mekatronik-achmadi/ecu_gea_v1/interface_win32/batik.png

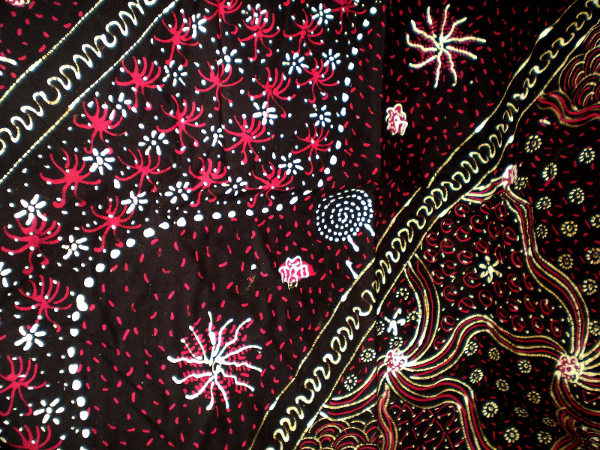
interface_win32/batik.png
