mekatronik-achmadi/ecu_gea_v1/README.md

ecu_gea_v1
==========

engine controller unit for gea engines. curently input only RPM and TPS
