mekatronik-achmadi/ecu_gea_v1/boards/PCB_Separated/platform_all1.brd

## EAGLE design boards/PCB_Separated/platform_all1.brd (2014-09-28)

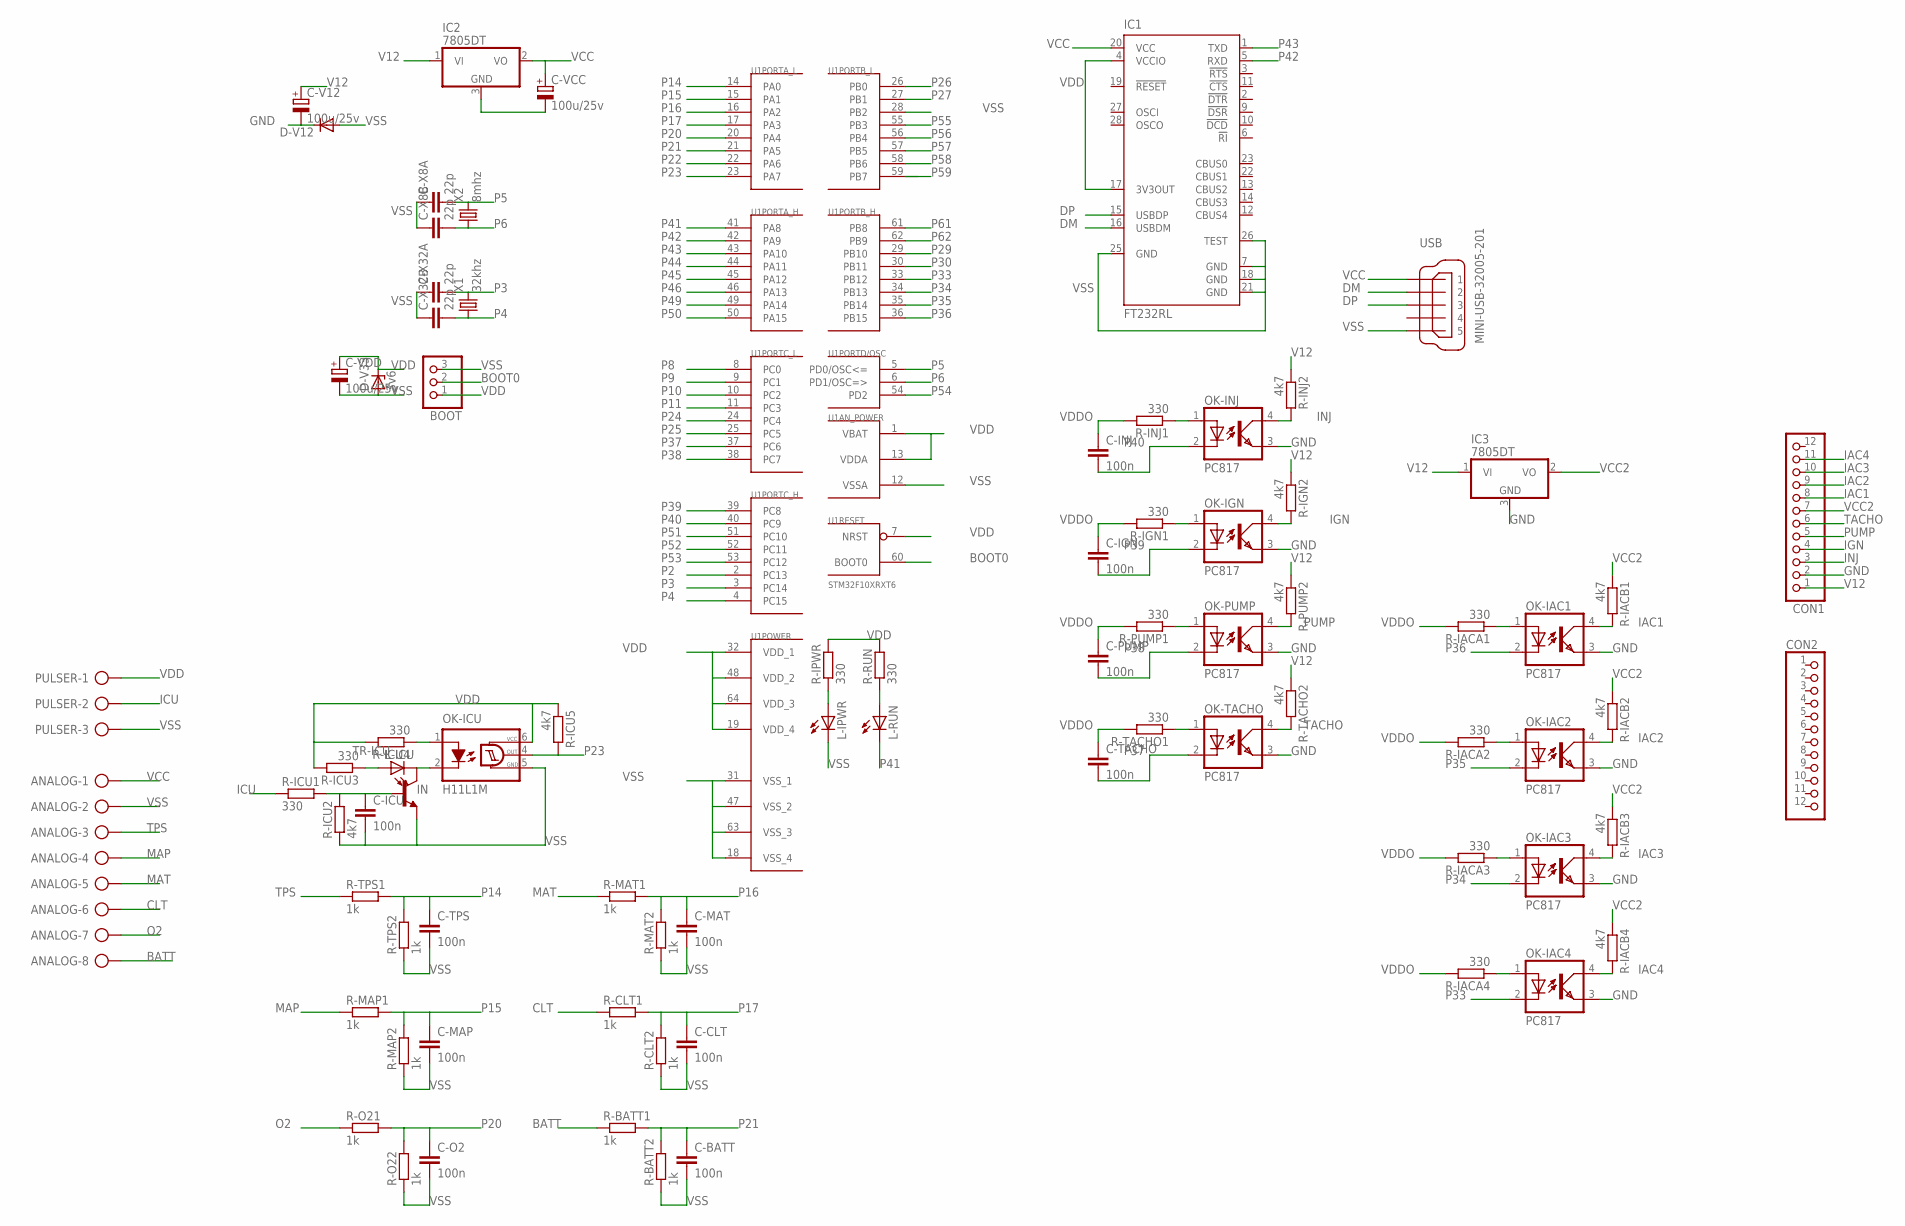
[picture p2: schematic platform_all1.sch]

Parts:
ANALOG: AK300/8
BOOT: PINHD-1X3; 1X03
C-BATT: 100n; C1206
C-CLT: 100n; C1206
C-ICU: 100n; C1206
C-IGN: 100n; C1206
C-INJ: 100n; C1206
C-MAP: 100n; C1206
C-MAT: 100n; C1206
C-O2: 100n; C1206
C-PUMP: 100n; C1206
C-TACHO: 100n; C1206
C-TPS: 100n; C1206
C-V12: 100u/25v; PANASONIC_D
C-VCC: 100u/25v; PANASONIC_D
C-VDD: 100u/25v; PANASONIC_D
C-X8A, C-X8B, C-X32A, C-X32B: 22p; C1206
CON1, CON2: PINHD-1X12; 1X12
D-V12: DIODE-SMB; SMB
D-V33: 3v6; SMB
IC1: FT232RL; SSOP28
IC2, IC3: 7805DT; TO252
L-ICU: LEDSMT1206; 1206
L-IPWR: LEDSMT1206; 1206
L-RUN: LEDSMT1206; 1206
OK-IAC1, OK-IAC2, OK-IAC3, OK-IAC4: PC817; DIL04
OK-ICU: H11L1M; DIL06
OK-IGN: PC817; DIL04
OK-INJ: PC817; DIL04
OK-PUMP: PC817; DIL04
OK-TACHO: PC817; DIL04
PULSER: AK300/3
R-BATT1, R-BATT2: 1k; R1206
R-CLT1, R-CLT2: 1k; R1206
R-IACA1, R-IACA2, R-IACA3, R-IACA4: 330; R1206
R-IACB1, R-IACB2, R-IACB3, R-IACB4: 4k7; R1206
R-ICU1, R-ICU3, R-ICU4: 330; R1206
R-ICU2, R-ICU5: 4k7; R1206
R-IGN1: 330; R1206
R-IGN2: 4k7; R1206
R-INJ1: 330; R1206
R-INJ2: 4k7; R1206
R-IPWR: 330; R1206
R-MAP1, R-MAP2: 1k; R1206
R-MAT1, R-MAT2: 1k; R1206
R-O21, R-O22: 1k; R1206
R-PUMP1: 330; R1206
R-PUMP2: 4k7; R1206
R-RUN: 330; R1206
R-TACHO1: 330; R1206
R-TACHO2: 4k7; R1206
R-TPS1, R-TPS2: 1k; R1206
TR-ICU: MMBT3904LT1-NPN-SOT23-BEC; SOT23-BEC
U1: STM32F10XRXT6; TQFP64
USB: MINI-USB-32005-201; 32005-201
X1: 32khz; TC26V
X2: 8mhz; HC49U-V

Connections:
BATT: ANALOG.8, R-BATT1.1
BOOT0: BOOT.2, U1.60 (BOOT0)
CLT: ANALOG.6, R-CLT1.1
DM: IC1.16 (USBDM), USB.2
DP: IC1.15 (USBDP), USB.3
GND: C-V12.-, CON1.2, D-V12.C, IC3.3 (GND), OK-IAC1.3 (EMIT), OK-IAC2.3 (EMIT), OK-IAC3.3 (EMIT), OK-IAC4.3 (EMIT), OK-IGN.3 (EMIT), OK-INJ.3 (EMIT), OK-PUMP.3 (EMIT), OK-TACHO.3 (EMIT)
IAC1: CON1.8, OK-IAC1.4 (COL), R-IACB1.2
IAC2: CON1.9, OK-IAC2.4 (COL), R-IACB2.2
IAC3: CON1.10, OK-IAC3.4 (COL), R-IACB3.2
IAC4: CON1.11, OK-IAC4.4 (COL), R-IACB4.2
ICU: PULSER.2, R-ICU1.1
IGN: CON1.4, OK-IGN.4 (COL), R-IGN2.2
IN: L-ICU.C, OK-ICU.2 (C), TR-ICU.C
INJ: CON1.3, OK-INJ.4 (COL), R-INJ2.2
MAP: ANALOG.4, R-MAP1.1
MAT: ANALOG.5, R-MAT1.1
unnamed: OK-TACHO.1 (A), R-TACHO1.1
unnamed: OK-IAC2.1 (A), R-IACA2.1
unnamed: C-ICU.1, R-ICU1.2, R-ICU2.2, TR-ICU.B
unnamed: OK-IAC1.1 (A), R-IACA1.1
unnamed: OK-ICU.1 (A), R-ICU4.1
unnamed: L-ICU.A, R-ICU3.1
unnamed: L-IPWR.A, R-IPWR.1
unnamed: L-RUN.A, R-RUN.1
unnamed: OK-PUMP.1 (A), R-PUMP1.1
unnamed: OK-IAC3.1 (A), R-IACA3.1
unnamed: OK-IAC4.1 (A), R-IACA4.1
unnamed: OK-INJ.1 (A), R-INJ1.1
unnamed: OK-IGN.1 (A), R-IGN1.1
O2: ANALOG.7, R-O21.1
P2: U1.2 (PC13)
P3: C-X32A.2, U1.3 (PC14), X1.2
P4: C-X32B.2, U1.4 (PC15), X1.1
P5: C-X8A.2, U1.5 (PD0/OSC<=), X2.2
P6: C-X8B.2, U1.6 (PD1/OSC=>), X2.1
P8: U1.8 (PC0)
P9: U1.9 (PC1)
P10: U1.10 (PC2)
P11: U1.11 (PC3)
P14: C-TPS.1, R-TPS1.2, R-TPS2.2, U1.14 (PA0)
P15: C-MAP.1, R-MAP1.2, R-MAP2.2, U1.15 (PA1)
P16: C-MAT.1, R-MAT1.2, R-MAT2.2, U1.16 (PA2)
P17: C-CLT.1, R-CLT1.2, R-CLT2.2, U1.17 (PA3)
P20: C-O2.1, R-O21.2, R-O22.2, U1.20 (PA4)
P21: C-BATT.1, R-BATT1.2, R-BATT2.2, U1.21 (PA5)
P22: U1.22 (PA6)
P23: OK-ICU.4 (OUT), R-ICU5.2, U1.23 (PA7)
P24: U1.24 (PC4)
P25: U1.25 (PC5)
P26: U1.26 (PB0)
P27: U1.27 (PB1)
P29: U1.29 (PB10)
P30: U1.30 (PB11)
P33: OK-IAC4.2 (C), U1.33 (PB12)
P34: OK-IAC3.2 (C), U1.34 (PB13)
P35: OK-IAC2.2 (C), U1.35 (PB14)
P36: OK-IAC1.2 (C), U1.36 (PB15)
P37: C-TACHO.2, OK-TACHO.2 (C), U1.37 (PC6)
P38: C-PUMP.2, OK-PUMP.2 (C), U1.38 (PC7)
P39: C-IGN.2, OK-IGN.2 (C), U1.39 (PC8)
P40: C-INJ.2, OK-INJ.2 (C), U1.40 (PC9)
P41: L-RUN.C, U1.41 (PA8)
P42: IC1.5 (RXD), U1.42 (PA9)
P43: IC1.1 (TXD), U1.43 (PA10)
P44: U1.44 (PA11)
P45: U1.45 (PA12)
P46: U1.46 (PA13)
P49: U1.49 (PA14)
P50: U1.50 (PA15)
P51: U1.51 (PC10)
P52: U1.52 (PC11)
P53: U1.53 (PC12)
P54: U1.54 (PD2)
P55: U1.55 (PB3)
P56: U1.56 (PB4)
P57: U1.57 (PB5)
P58: U1.58 (PB6)
P59: U1.59 (PB7)
P61: U1.61 (PB8)
P62: U1.62 (PB9)
PUMP: CON1.5, OK-PUMP.4 (COL), R-PUMP2.2
TACHO: CON1.6, OK-TACHO.4 (COL), R-TACHO2.2
TPS: ANALOG.3, R-TPS1.1
V12: C-V12.+, CON1.1, IC2.1 (VI), IC3.1 (VI), R-IGN2.1, R-INJ2.1, R-PUMP2.1, R-TACHO2.1
VCC: ANALOG.1, C-VCC.+, IC1.20 (VCC), IC2.2 (VO), USB.1
VCC2: CON1.7, IC3.2 (VO), R-IACB1.1, R-IACB2.1, R-IACB3.1, R-IACB4.1
VDD: BOOT.1, C-VDD.+, D-V33.C, IC1.4 (VCCIO), IC1.17 (3V3OUT), OK-ICU.6 (VCC), PULSER.1, R-ICU3.2, R-ICU4.2, R-ICU5.1, R-IPWR.2, R-RUN.2, U1.1 (VBAT), U1.7 (NRST), U1.13 (VDDA), U1.19 (VDD_4), U1.32 (VDD_1), U1.48 (VDD_2), U1.64 (VDD_3)
VDDO: C-IGN.1, C-INJ.1, C-PUMP.1, C-TACHO.1, R-IACA1.2, R-IACA2.2, R-IACA3.2, R-IACA4.2, R-IGN1.2, R-INJ1.2, R-PUMP1.2, R-TACHO1.2
VSS: ANALOG.2, BOOT.3, C-BATT.2, C-CLT.2, C-ICU.2, C-MAP.2, C-MAT.2, C-O2.2, C-TPS.2, C-VCC.-, C-VDD.-, C-X8A.1, C-X8B.1, C-X32A.1, C-X32B.1, D-V12.A, D-V33.A, IC1.7 (GND), IC1.18 (GND), IC1.21 (GND), IC1.25 (GND), IC1.26 (TEST), IC2.3 (GND), L-IPWR.C, OK-ICU.5 (GND), PULSER.3, R-BATT2.1, R-CLT2.1, R-ICU2.1, R-MAP2.1, R-MAT2.1, R-O22.1, R-TPS2.1, TR-ICU.E, U1.12 (VSSA), U1.18 (VSS_4), U1.28 (PB2), U1.31 (VSS_1), U1.47 (VSS_2), U1.63 (VSS_3), USB.5

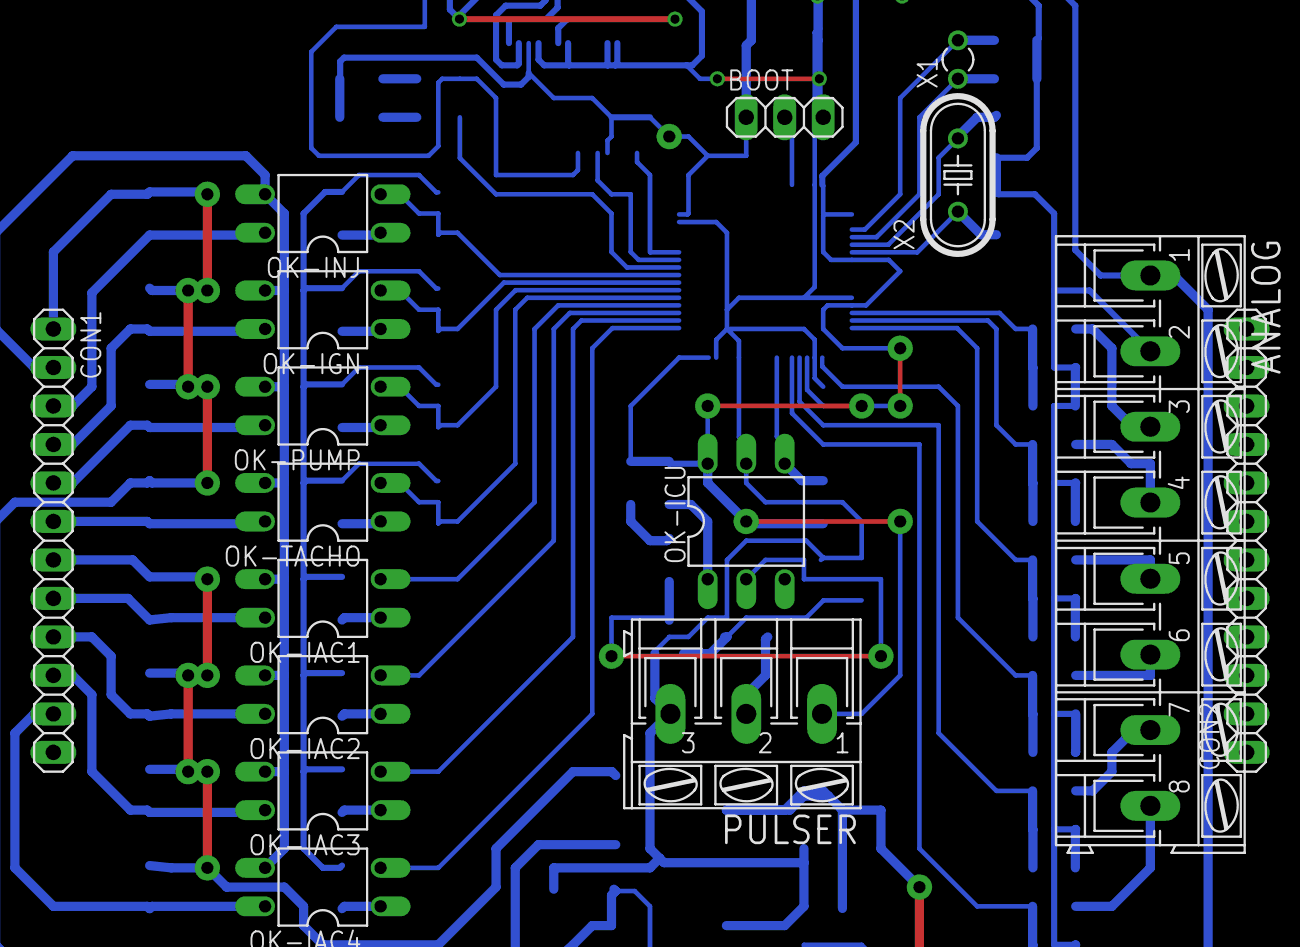
[picture p3: board platform_all1.brd from above]

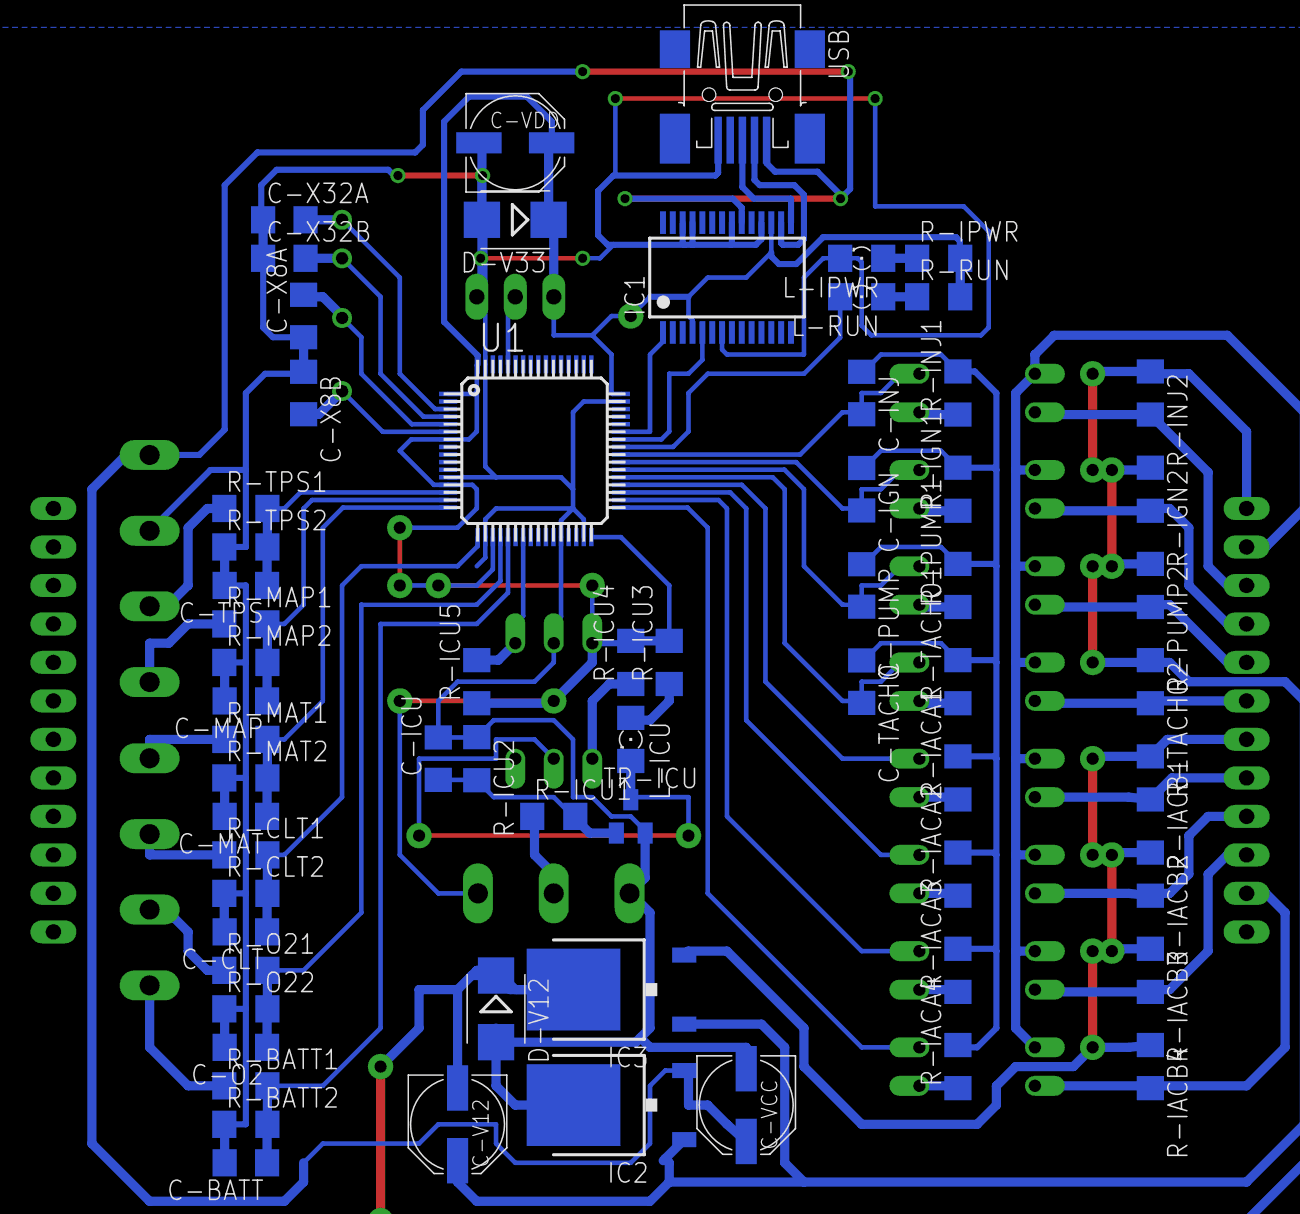
[picture p4: board platform_all1.brd from below]

Board: 2 copper layers, 80 parts (64 on the bottom side), 61 nets.
