mekatronik-achmadi/ecu_gea_v1/boards/PCB_Separated/platform_driver_all2.brd

## EAGLE design boards/PCB_Separated/platform_driver_all2.brd (2014-09-16)

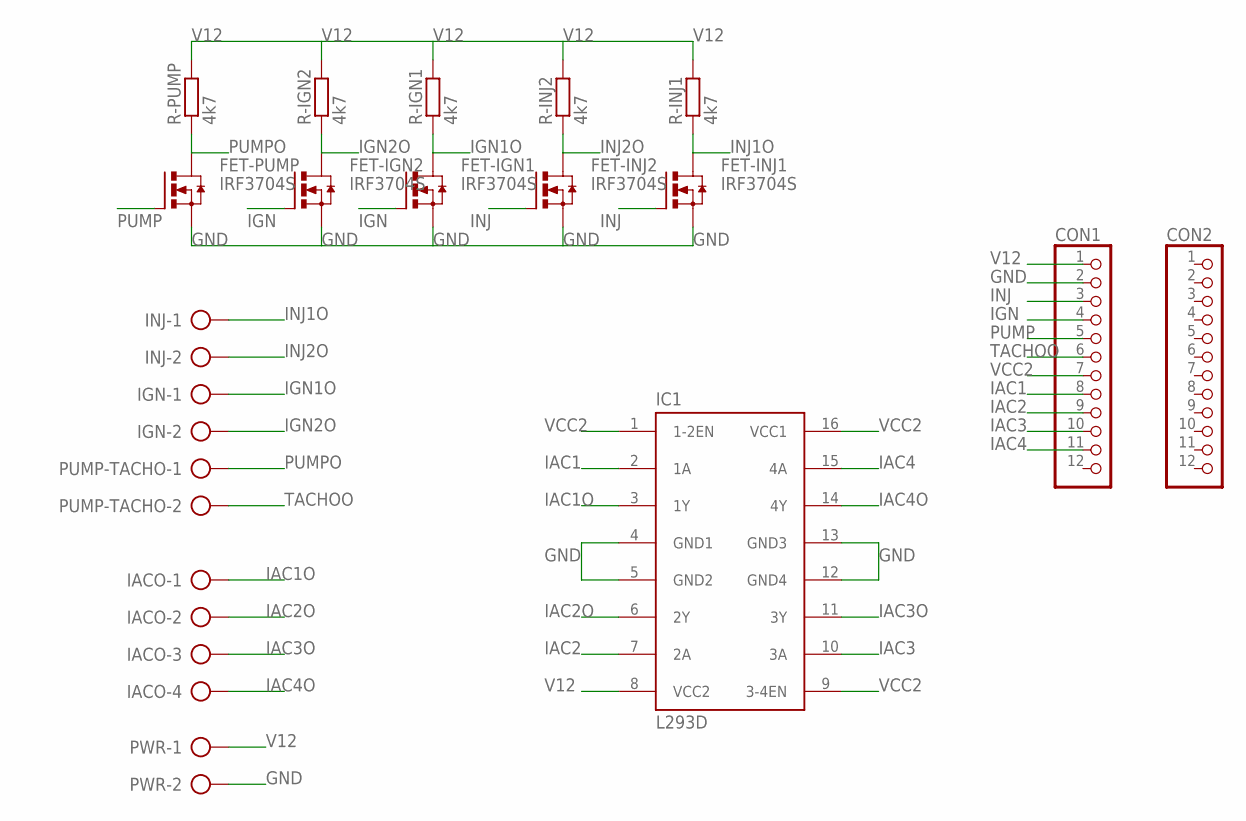
[picture p5: schematic platform_driver_all2.sch]

Parts:
CON1, CON2: PINHD-1X12; 1X12
FET-IGN1, FET-IGN2: IRF3704S; D2PACK
FET-INJ1, FET-INJ2: IRF3704S; D2PACK
FET-PUMP: IRF3704S; D2PACK
IACO: AK300/4
IC1: L293D; DIL16
IGN: AK300/2
INJ: AK300/2
PUMP-TACHO: AK300/2
PWR: AK300/2
R-IGN1, R-IGN2: 4k7; M1206
R-INJ1, R-INJ2: 4k7; M1206
R-PUMP: 4k7; M1206

Connections:
GND: CON1.2, FET-IGN1.3 (S), FET-IGN2.3 (S), FET-INJ1.3 (S), FET-INJ2.3 (S), FET-PUMP.3 (S), IC1.4 (GND1), IC1.5 (GND2), IC1.12 (GND4), IC1.13 (GND3), PWR.2
IAC1: CON1.8, IC1.2 (1A)
IAC1O: IACO.1, IC1.3 (1Y)
IAC2: CON1.9, IC1.7 (2A)
IAC2O: IACO.2, IC1.6 (2Y)
IAC3: CON1.10, IC1.10 (3A)
IAC3O: IACO.3, IC1.11 (3Y)
IAC4: CON1.11, IC1.15 (4A)
IAC4O: IACO.4, IC1.14 (4Y)
IGN: CON1.4, FET-IGN1.1 (G), FET-IGN2.1 (G)
IGN1O: FET-IGN1.2 (D), IGN.1, R-IGN1.1
IGN2O: FET-IGN2.2 (D), IGN.2, R-IGN2.1
INJ: CON1.3, FET-INJ1.1 (G), FET-INJ2.1 (G)
INJ1O: FET-INJ1.2 (D), INJ.1, R-INJ1.1
INJ2O: FET-INJ2.2 (D), INJ.2, R-INJ2.1
PUMP: CON1.5, FET-PUMP.1 (G)
PUMPO: FET-PUMP.2 (D), PUMP-TACHO.1, R-PUMP.1
TACHOO: CON1.6, PUMP-TACHO.2
V12: CON1.1, IC1.8 (VCC2), PWR.1, R-IGN1.2, R-IGN2.2, R-INJ1.2, R-INJ2.2, R-PUMP.2
VCC2: CON1.7, IC1.1 (1-2EN), IC1.9 (3-4EN), IC1.16 (VCC1)

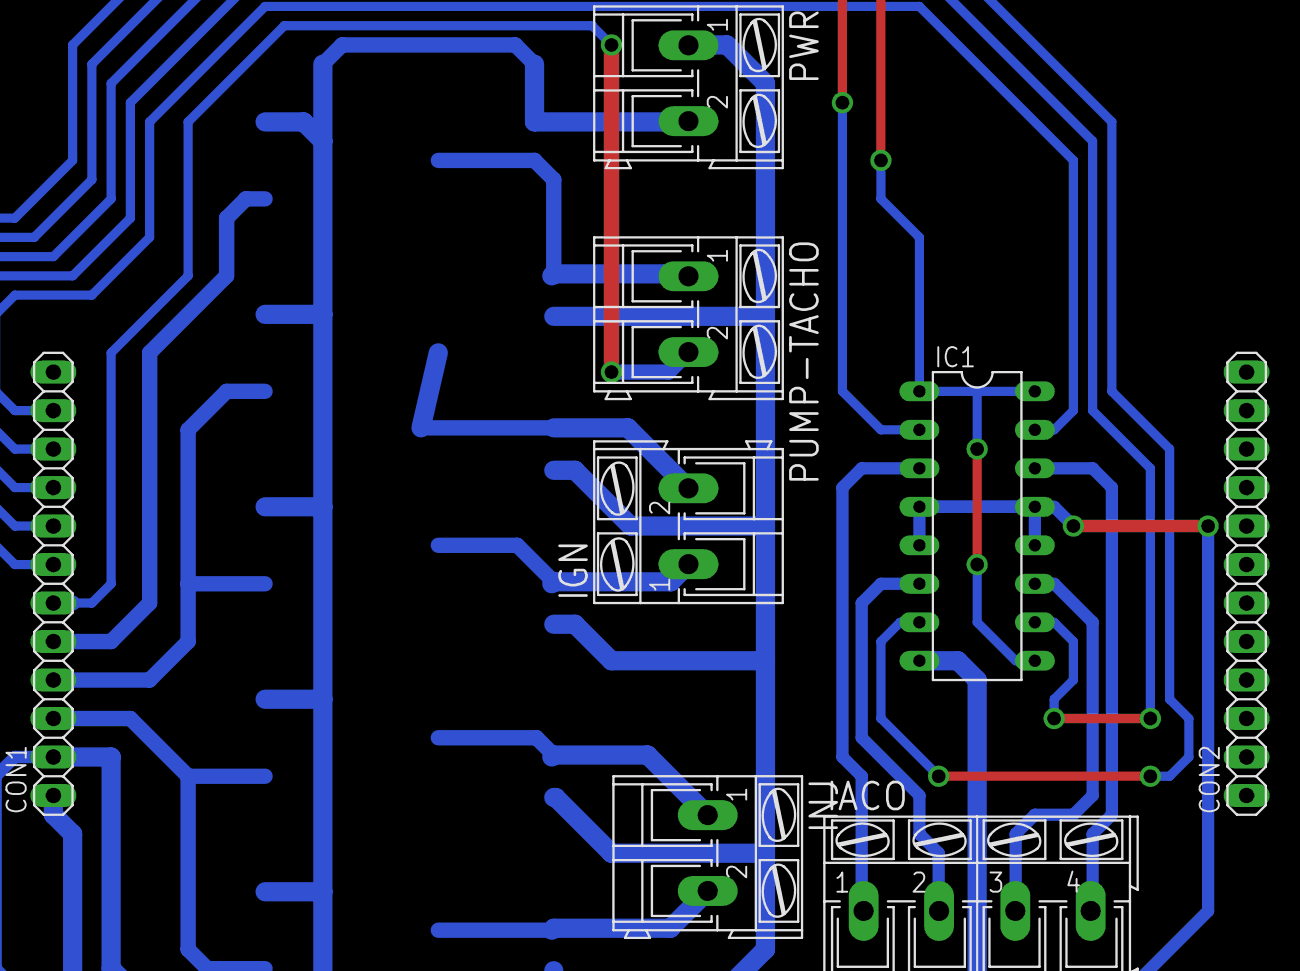
[picture p6: board platform_driver_all2.brd from above]

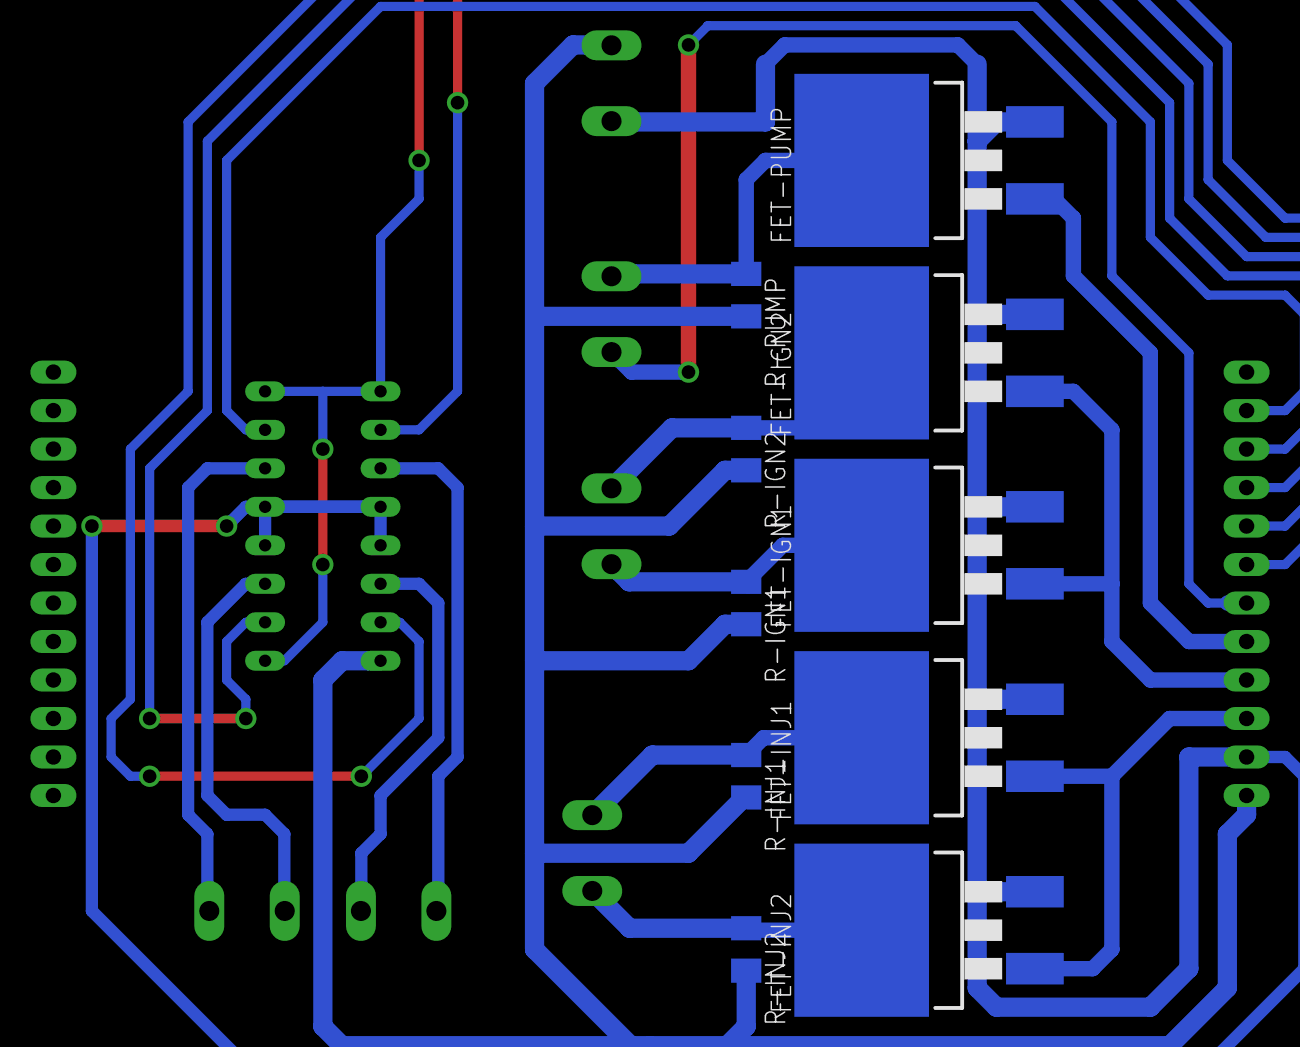
[picture p7: board platform_driver_all2.brd from below]

Board: 2 copper layers, 18 parts (10 on the bottom side), 20 nets.
