mekatronik-achmadi/ecu_gea_v1/boards/PCB_Separated/platform_smd2_driver.brd

## EAGLE design boards/PCB_Separated/platform_smd2_driver.brd (2014-06-27)

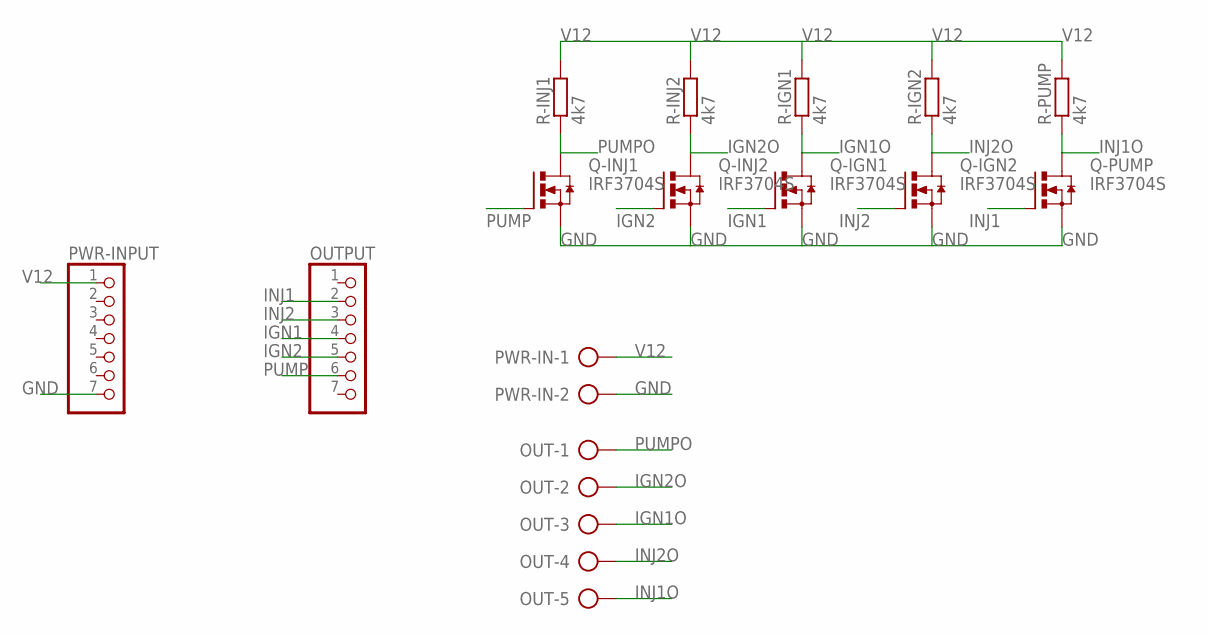
[picture p8: schematic platform_smd2_driver.sch]

Parts:
OUT: AK300/5
OUTPUT: PINHD-1X7; 1X07
PWR-IN: AK300/2
PWR-INPUT: PINHD-1X7; 1X07
Q-IGN1, Q-IGN2: IRF3704S; D2PACK
Q-INJ1, Q-INJ2: IRF3704S; D2PACK
Q-PUMP: IRF3704S; D2PACK
R-IGN1, R-IGN2: 4k7; M1206
R-INJ1, R-INJ2: 4k7; M1206
R-PUMP: 4k7; M1206

Connections:
GND: PWR-IN.2, PWR-INPUT.7, Q-IGN1.3 (S), Q-IGN2.3 (S), Q-INJ1.3 (S), Q-INJ2.3 (S), Q-PUMP.3 (S)
IGN1: OUTPUT.4, Q-IGN1.1 (G)
IGN1O: OUT.3, Q-IGN1.2 (D), R-IGN1.1
IGN2: OUTPUT.5, Q-INJ2.1 (G)
IGN2O: OUT.2, Q-INJ2.2 (D), R-INJ2.1
INJ1: OUTPUT.2, Q-PUMP.1 (G)
INJ1O: OUT.5, Q-PUMP.2 (D), R-PUMP.1
INJ2: OUTPUT.3, Q-IGN2.1 (G)
INJ2O: OUT.4, Q-IGN2.2 (D), R-IGN2.1
PUMP: OUTPUT.6, Q-INJ1.1 (G)
PUMPO: OUT.1, Q-INJ1.2 (D), R-INJ1.1
V12: PWR-IN.1, PWR-INPUT.1, R-IGN1.2, R-IGN2.2, R-INJ1.2, R-INJ2.2, R-PUMP.2

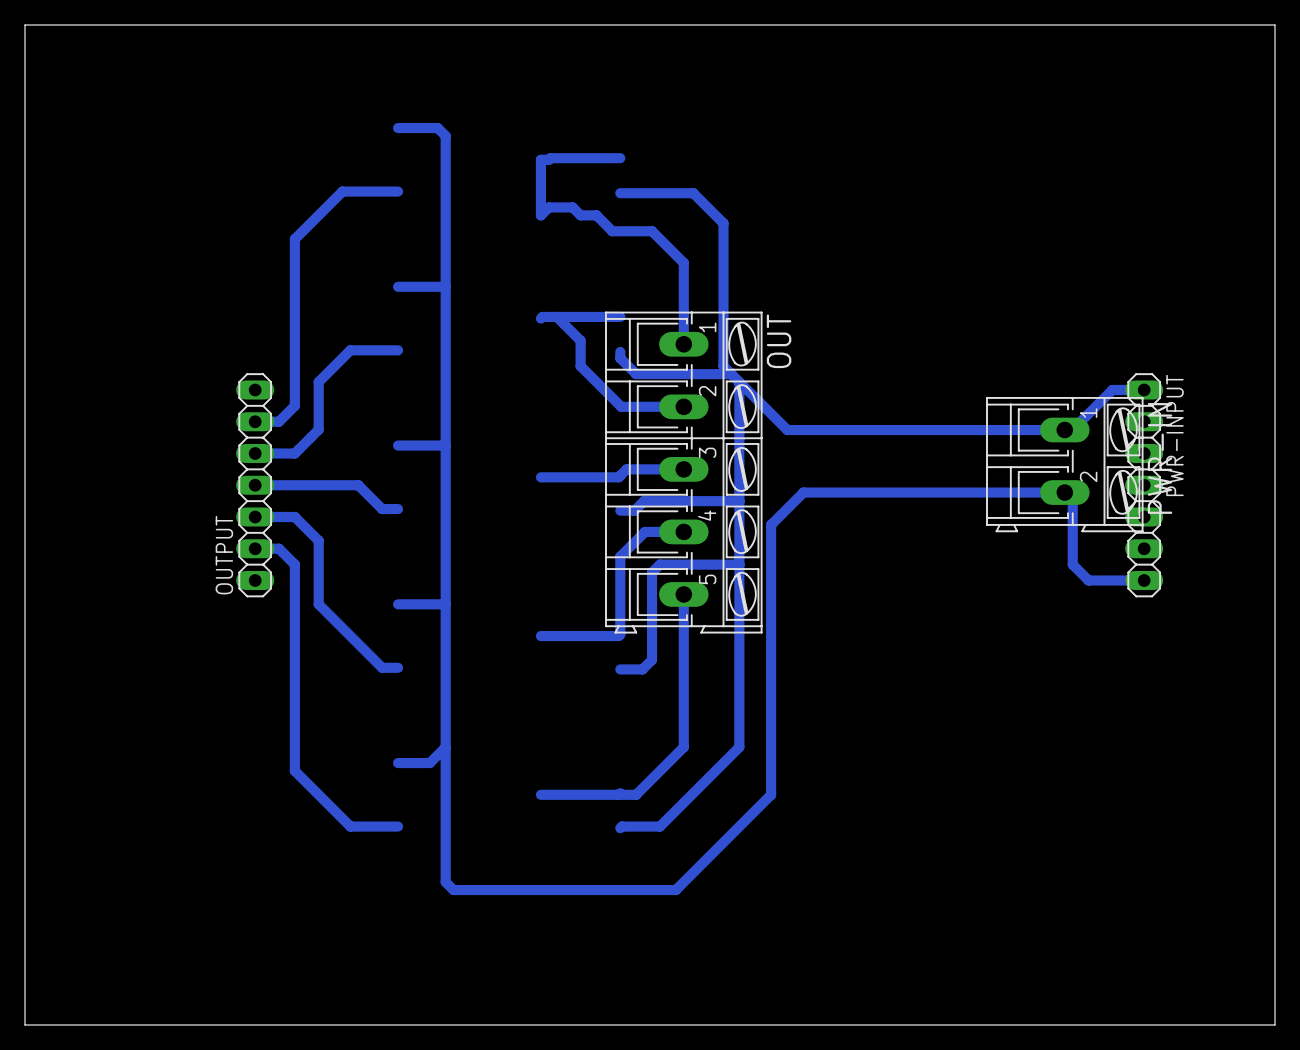
[picture p9: board platform_smd2_driver.brd from above]

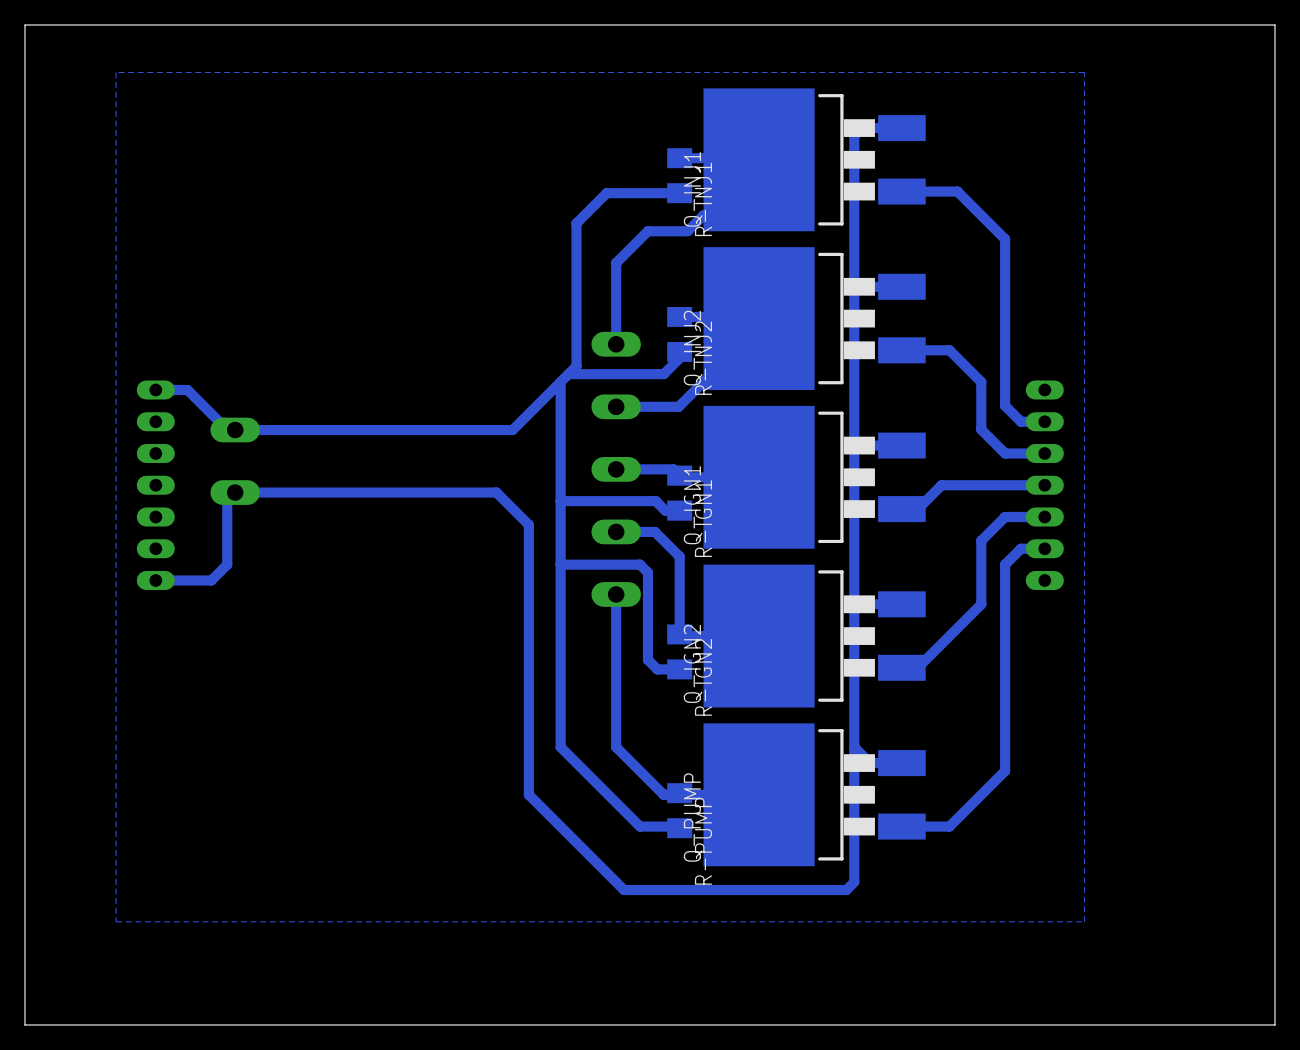
[picture p10: board platform_smd2_driver.brd from below]

Board: 2 copper layers, 100.0 x 80.0 mm, 14 parts (10 on the bottom side), 12 nets.
