mekatronik-achmadi/ecu_gea_v1/boards/PCB_Separated/platform_smd2.brd

## EAGLE design boards/PCB_Separated/platform_smd2.brd (2014-06-22)

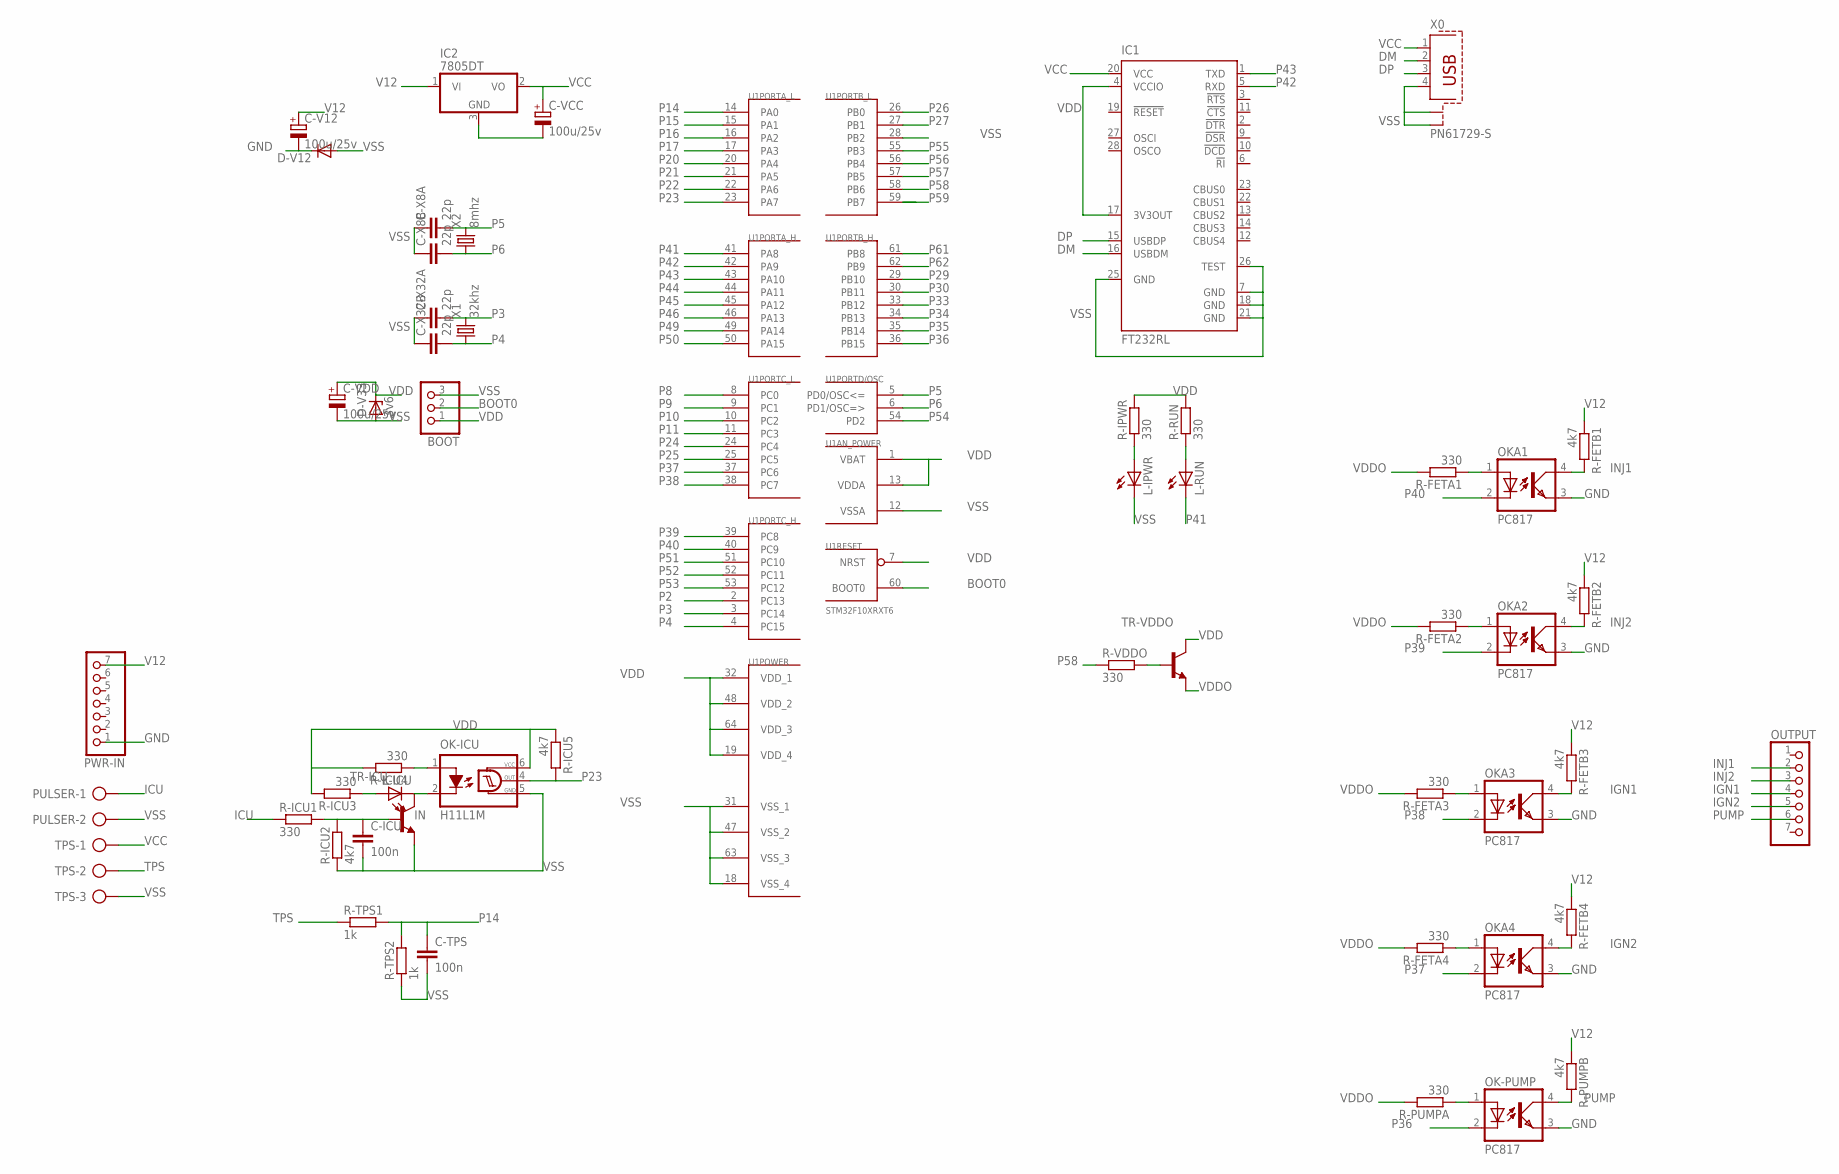
[picture p11: schematic platform_smd2.sch]

Parts:
BOOT: PINHD-1X3; 1X03
C-ICU: 100n; C1206
C-TPS: 100n; C1206
C-V12: 100u/25v; PANASONIC_D
C-VCC: 100u/25v; PANASONIC_D
C-VDD: 100u/25v; PANASONIC_D
C-X8A, C-X8B, C-X32A, C-X32B: 22p; C1206
D-V12: DIODE-SMB; SMB
D-V33: 3v6; SMB
IC1: FT232RL; SSOP28
IC2: 7805DT; TO252
L-ICU: LEDSML0805; SML0805
L-IPWR: LEDSMT1206; 1206
L-RUN: LEDSMT1206; 1206
OK-ICU: H11L1M; DIL06
OK-PUMP: PC817; DIL04
OKA1, OKA2, OKA3, OKA4: PC817; DIL04
OUTPUT: PINHD-1X7; 1X07
PULSER: AK300/2
PWR-IN: PINHD-1X7; 1X07
R-FETA1, R-FETA2, R-FETA3, R-FETA4: 330; R1206
R-FETB1, R-FETB2, R-FETB3, R-FETB4: 4k7; R1206
R-ICU1, R-ICU3, R-ICU4: 330; R1206
R-ICU2, R-ICU5: 4k7; R1206
R-IPWR: 330; R1206
R-PUMPA: 330; R1206
R-PUMPB: 4k7; R1206
R-RUN: 330; R1206
R-TPS1, R-TPS2: 1k; R1206
R-VDDO: 330; R0805
TPS: AK300/3
TR-ICU: MMBT3904LT1-NPN-SOT23-BEC; SOT23-BEC
TR-VDDO: MMBT3904LT1-NPN-SOT23-BEC; SOT23-BEC
U1: STM32F10XRXT6; TQFP64
X0: PN61729-S
X1: 32khz; TC26V
X2: 8mhz; HC49U-V

Connections:
BOOT0: BOOT.2, U1.60 (BOOT0)
DM: IC1.16 (USBDM), X0.2
DP: IC1.15 (USBDP), X0.3
GND: C-V12.-, D-V12.C, OK-PUMP.3 (EMIT), OKA1.3 (EMIT), OKA2.3 (EMIT), OKA3.3 (EMIT), OKA4.3 (EMIT), PWR-IN.1
ICU: PULSER.1, R-ICU1.1
IGN1: OKA3.4 (COL), OUTPUT.4, R-FETB3.2
IGN2: OKA4.4 (COL), OUTPUT.5, R-FETB4.2
IN: L-ICU.C, OK-ICU.2 (C), TR-ICU.C
INJ1: OKA1.4 (COL), OUTPUT.2, R-FETB1.2
INJ2: OKA2.4 (COL), OUTPUT.3, R-FETB2.2
unnamed: C-ICU.1, R-ICU1.2, R-ICU2.2, TR-ICU.B
unnamed: OK-ICU.1 (A), R-ICU4.1
unnamed: L-ICU.A, R-ICU3.1
unnamed: L-IPWR.A, R-IPWR.1
unnamed: L-RUN.A, R-RUN.1
unnamed: OK-PUMP.1 (A), R-PUMPA.1
unnamed: OKA2.1 (A), R-FETA2.1
unnamed: OKA1.1 (A), R-FETA1.1
unnamed: OKA3.1 (A), R-FETA3.1
unnamed: OKA4.1 (A), R-FETA4.1
unnamed: R-VDDO.2, TR-VDDO.B
P2: U1.2 (PC13)
P3: C-X32A.2, U1.3 (PC14), X1.2
P4: C-X32B.2, U1.4 (PC15), X1.1
P5: C-X8A.2, U1.5 (PD0/OSC<=), X2.2
P6: C-X8B.2, U1.6 (PD1/OSC=>), X2.1
P8: U1.8 (PC0)
P9: U1.9 (PC1)
P10: U1.10 (PC2)
P11: U1.11 (PC3)
P14: C-TPS.1, R-TPS1.2, R-TPS2.2, U1.14 (PA0)
P15: U1.15 (PA1)
P16: U1.16 (PA2)
P17: U1.17 (PA3)
P20: U1.20 (PA4)
P21: U1.21 (PA5)
P22: U1.22 (PA6)
P23: OK-ICU.4 (OUT), R-ICU5.2, U1.23 (PA7)
P24: U1.24 (PC4)
P25: U1.25 (PC5)
P26: U1.26 (PB0)
P27: U1.27 (PB1)
P29: U1.29 (PB10)
P30: U1.30 (PB11)
P33: U1.33 (PB12)
P34: U1.34 (PB13)
P35: U1.35 (PB14)
P36: OK-PUMP.2 (C), U1.36 (PB15)
P37: OKA4.2 (C), U1.37 (PC6)
P38: OKA3.2 (C), U1.38 (PC7)
P39: OKA2.2 (C), U1.39 (PC8)
P40: OKA1.2 (C), U1.40 (PC9)
P41: L-RUN.C, U1.41 (PA8)
P42: IC1.5 (RXD), U1.42 (PA9)
P43: IC1.1 (TXD), U1.43 (PA10)
P44: U1.44 (PA11)
P45: U1.45 (PA12)
P46: U1.46 (PA13)
P49: U1.49 (PA14)
P50: U1.50 (PA15)
P51: U1.51 (PC10)
P52: U1.52 (PC11)
P53: U1.53 (PC12)
P54: U1.54 (PD2)
P55: U1.55 (PB3)
P56: U1.56 (PB4)
P57: U1.57 (PB5)
P58: R-VDDO.1, U1.58 (PB6)
P59: U1.59 (PB7)
P61: U1.61 (PB8)
P62: U1.62 (PB9)
PUMP: OK-PUMP.4 (COL), OUTPUT.6, R-PUMPB.2
TPS: R-TPS1.1, TPS.2
V12: C-V12.+, IC2.1 (VI), PWR-IN.7, R-FETB1.1, R-FETB2.1, R-FETB3.1, R-FETB4.1, R-PUMPB.1
VCC: C-VCC.+, IC1.20 (VCC), IC2.2 (VO), TPS.1, X0.1
VDD: BOOT.1, C-VDD.+, D-V33.C, IC1.4 (VCCIO), IC1.17 (3V3OUT), OK-ICU.6 (VCC), R-ICU3.2, R-ICU4.2, R-ICU5.1, R-IPWR.2, R-RUN.2, TR-VDDO.C, U1.1 (VBAT), U1.7 (NRST), U1.13 (VDDA), U1.19 (VDD_4), U1.32 (VDD_1), U1.48 (VDD_2), U1.64 (VDD_3)
VDDO: R-FETA1.2, R-FETA2.2, R-FETA3.2, R-FETA4.2, R-PUMPA.2, TR-VDDO.E
VSS: BOOT.3, C-ICU.2, C-TPS.2, C-VCC.-, C-VDD.-, C-X8A.1, C-X8B.1, C-X32A.1, C-X32B.1, D-V12.A, D-V33.A, IC1.7 (GND), IC1.18 (GND), IC1.21 (GND), IC1.25 (GND), IC1.26 (TEST), IC2.3 (GND), L-IPWR.C, OK-ICU.5 (GND), PULSER.2, R-ICU2.1, R-TPS2.1, TPS.3, TR-ICU.E, U1.12 (VSSA), U1.18 (VSS_4), U1.28 (PB2), U1.31 (VSS_1), U1.47 (VSS_2), U1.63 (VSS_3), X0.4, X0.S1, X0.S2
