mekatronik-achmadi/ecu_gea_v1/boards/PCB_Separated/platform_smd2.brd

## EAGLE design boards/PCB_Separated/platform_smd2.brd (continued)

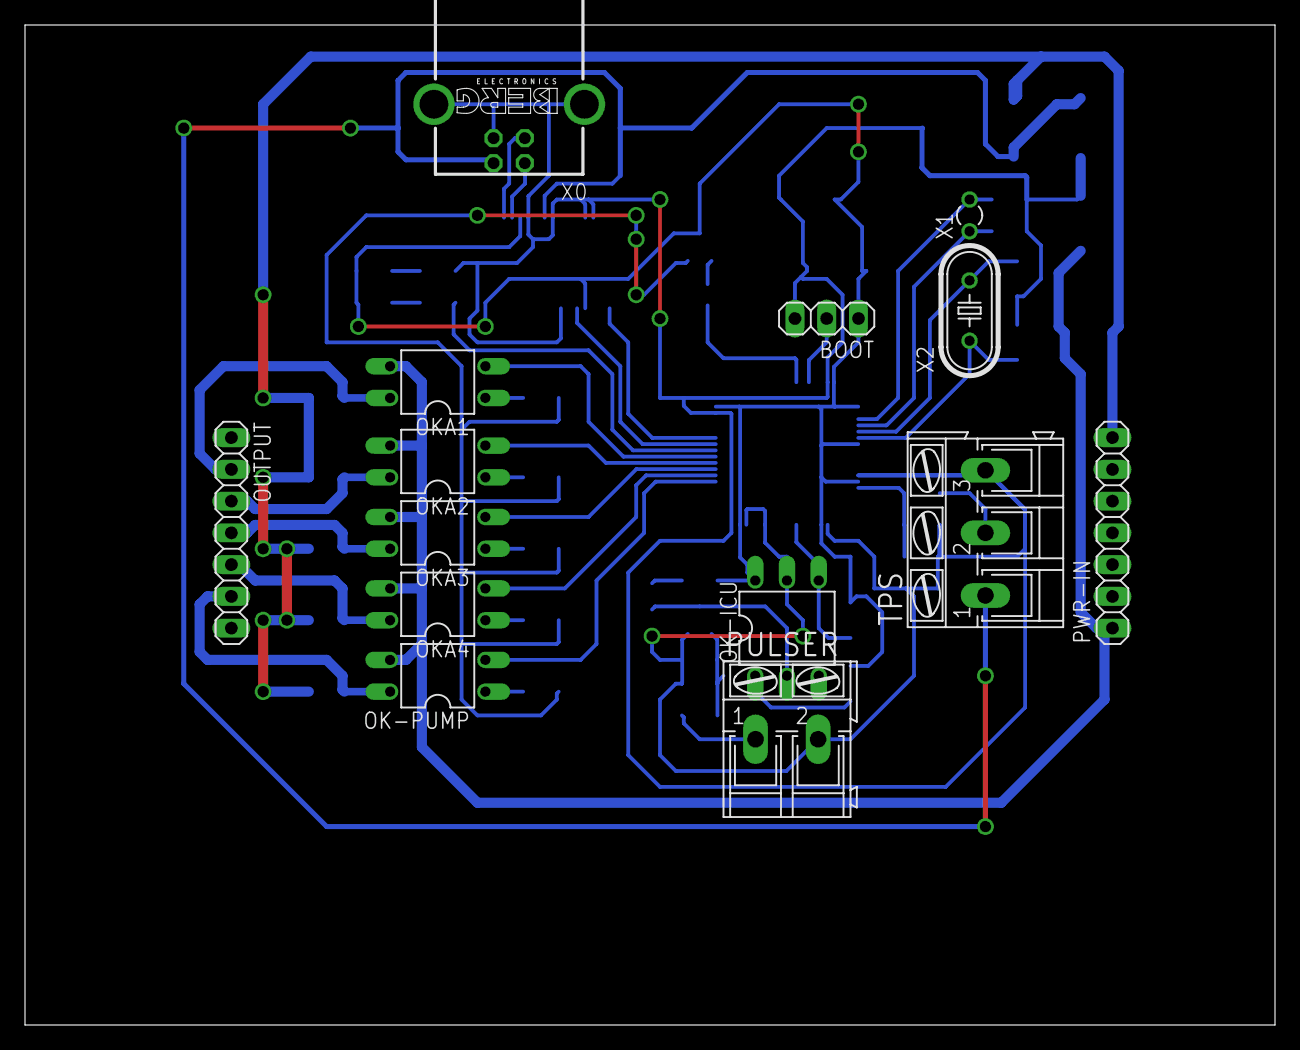
[picture p12: board platform_smd2.brd from above]

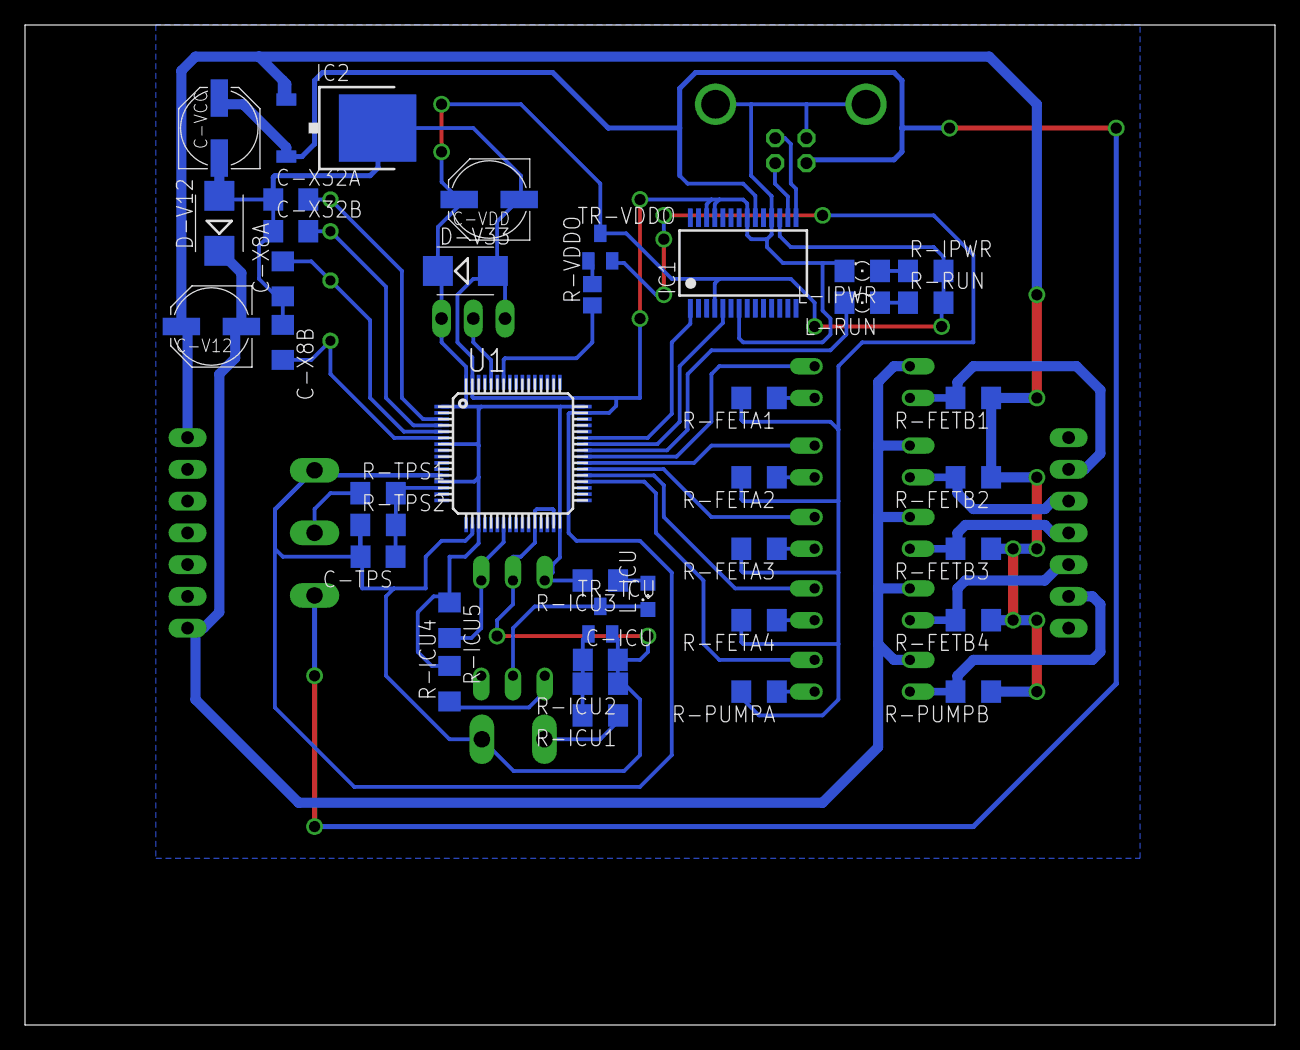
[picture p13: board platform_smd2.brd from below]

Board: 2 copper layers, 100.0 x 80.0 mm, 53 parts (39 on the bottom side), 43 nets.
