mekatronik-achmadi/ecu_gea_v1/boards/PCB_Separated/platform2.brd

## EAGLE design boards/PCB_Separated/platform2.brd (2014-05-21)

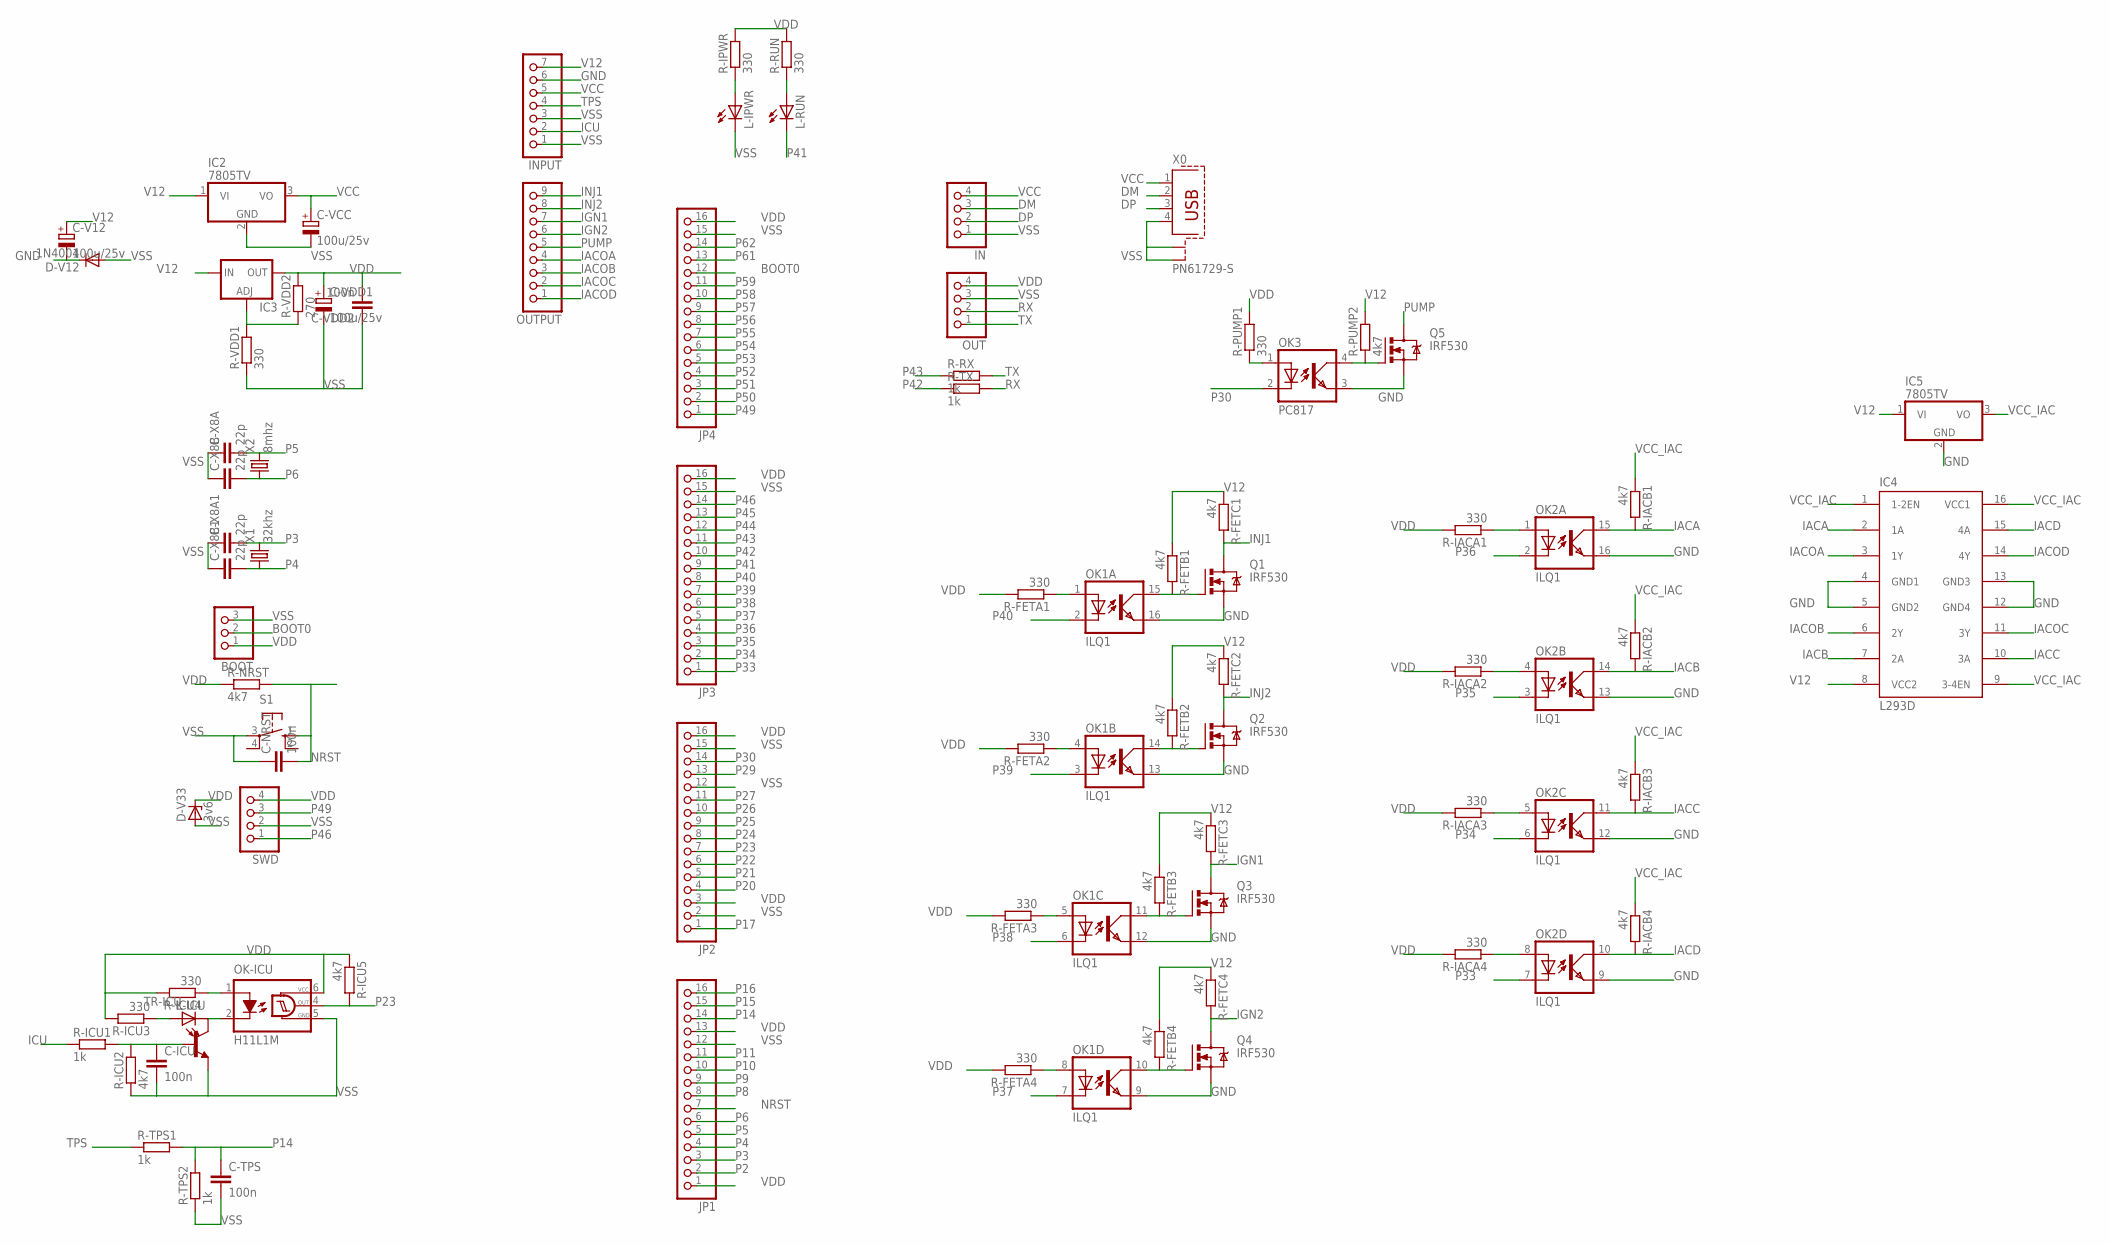
[picture p14: schematic platform2.sch]

Parts:
BOOT: PINHD-1X3; 1X03
C-ICU: 100n; C050-024X044
C-NRST: 100n; C050-024X044
C-TPS: 100n; C050-024X044
C-V12: 100u/25v; E2-5
C-VCC: 100u/25v; E2-5
C-VDD1: 100u/25v; E2-5
C-VDD2: 100n; C050-024X044
C-X8A, C-X8A1, C-X8B, C-X8B1: 22p; C025-024X044
D-V12: 1N4004; DO41-10
D-V33: 3v6; ZDIO-7.5
IC2, IC5: 7805TV; TO220V
IC3: LM317TS; 317TS
IC4: L293D; DIL16
IN: PINHD-1X4; 1X04
INPUT: PINHD-1X7; 1X07
JP1, JP2, JP3, JP4: PINHD-1X16; 1X16
L-ICU: LED3MM
L-IPWR: LED3MM
L-RUN: LED3MM
OK1, OK2: ILQ1; DIL16
OK3: PC817; DIL04
OK-ICU: H11L1M; DIL06
OUT: PINHD-1X4; 1X04
OUTPUT: PINHD-1X9; 1X09
Q1, Q2, Q3, Q4, Q5: IRF530; TO220BV
R-FETA1, R-FETA2, R-FETA3, R-FETA4: 330; 0204/7
R-FETB1, R-FETB2, R-FETB3, R-FETB4: 4k7; 0204/7
R-FETC1, R-FETC2, R-FETC3, R-FETC4: 4k7; 0204/7
R-IACA1, R-IACA2, R-IACA3, R-IACA4: 330; 0204/7
R-IACB1, R-IACB2, R-IACB3, R-IACB4: 4k7; 0204/7
R-ICU1: 1k; 0204/7
R-ICU2, R-ICU5: 4k7; 0204/7
R-ICU3, R-ICU4: 330; 0204/7
R-IPWR: 330; 0204/7
R-NRST: 4k7; 0204/7
R-PUMP1: 330; 0204/7
R-PUMP2: 4k7; 0204/7
R-RUN: 330; 0204/7
R-RX: 1k; 0204/7
R-TPS1, R-TPS2: 1k; 0204/7
R-TX: 1k; 0204/7
R-VDD1: 330; 0204/7
R-VDD2: 270; 0204/7
S1: 10-XX; B3F-10XX
SWD: PINHD-1X4; 1X04
TR-ICU: 2N3904-NPN-TO92-EBC; TO92-EBC
X0: PN61729-S
X1: 32khz; TC26V
X2: 8mhz; HC49U-V

Connections:
BOOT0: BOOT.2, JP4.12
DM: IN.3, X0.2
DP: IN.2, X0.3
GND: C-V12.-, D-V12.C, IC4.4 (GND1), IC4.5 (GND2), IC4.12 (GND4), IC4.13 (GND3), IC5.2 (GND), INPUT.6, OK1.9 (EMIT), OK1.12 (EMIT), OK1.13 (EMIT), OK1.16 (EMIT), OK2.9 (EMIT), OK2.12 (EMIT), OK2.13 (EMIT), OK2.16 (EMIT), OK3.3 (EMIT), Q1.S, Q2.S, Q3.S, Q4.S, Q5.S
IACA: IC4.2 (1A), OK2.15 (COL), R-IACB1.2
IACB: IC4.7 (2A), OK2.14 (COL), R-IACB2.2
IACC: IC4.10 (3A), OK2.11 (COL), R-IACB3.2
IACD: IC4.15 (4A), OK2.10 (COL), R-IACB4.2
IACOA: IC4.3 (1Y), OUTPUT.4
IACOB: IC4.6 (2Y), OUTPUT.3
IACOC: IC4.11 (3Y), OUTPUT.2
IACOD: IC4.14 (4Y), OUTPUT.1
ICU: INPUT.2, R-ICU1.1
IGN1: OUTPUT.7, Q3.D, R-FETC3.2
IGN2: OUTPUT.6, Q4.D, R-FETC4.2
INJ1: OUTPUT.9, Q1.D, R-FETC1.2
INJ2: OUTPUT.8, Q2.D, R-FETC2.2
unnamed: OK1.14 (COL), Q2.G, R-FETB2.2
unnamed: C-ICU.1, R-ICU1.2, R-ICU2.2, TR-ICU.B
unnamed: L-ICU.K (C), OK-ICU.2 (C), TR-ICU.C
unnamed: OK-ICU.1 (A), R-ICU4.1
unnamed: L-ICU.A, R-ICU3.1
unnamed: L-IPWR.A, R-IPWR.1
unnamed: L-RUN.A, R-RUN.1
unnamed: OK3.1 (A), R-PUMP1.1
unnamed: OK2.1 (A), R-IACA1.1
unnamed: OK1.15 (COL), Q1.G, R-FETB1.2
unnamed: OK1.4 (A), R-FETA2.1
unnamed: OK1.1 (A), R-FETA1.1
unnamed: OK1.11 (COL), Q3.G, R-FETB3.2
unnamed: OK1.5 (A), R-FETA3.1
unnamed: OK1.10 (COL), Q4.G, R-FETB4.2
unnamed: OK1.8 (A), R-FETA4.1
unnamed: OK2.4 (A), R-IACA2.1
unnamed: OK3.4 (COL), Q5.G, R-PUMP2.1
unnamed: OK2.5 (A), R-IACA3.1
unnamed: OK2.8 (A), R-IACA4.1
unnamed: IC3.1 (ADJ), R-VDD1.2, R-VDD2.1
NRST: C-NRST.2, JP1.7, R-NRST.2, S1.1 (S)
P2: JP1.2
P3: C-X8A1.2, JP1.3, X1.2
P4: C-X8B1.2, JP1.4, X1.1
P5: C-X8A.2, JP1.5, X2.2
P6: C-X8B.2, JP1.6, X2.1
P8: JP1.8
P9: JP1.9
P10: JP1.10
P11: JP1.11
P14: C-TPS.1, JP1.14, R-TPS1.2, R-TPS2.2
P15: JP1.15
P16: JP1.16
P17: JP2.1
P20: JP2.4
P21: JP2.5
P22: JP2.6
P23: JP2.7, OK-ICU.4 (OUT), R-ICU5.2
P24: JP2.8
P25: JP2.9
P26: JP2.10
P27: JP2.11
P29: JP2.13
P30: JP2.14, OK3.2 (C)
P33: JP3.1, OK2.7 (C)
P34: JP3.2, OK2.6 (C)
P35: JP3.3, OK2.3 (C)
P36: JP3.4, OK2.2 (C)
P37: JP3.5, OK1.7 (C)
P38: JP3.6, OK1.6 (C)
P39: JP3.7, OK1.3 (C)
P40: JP3.8, OK1.2 (C)
P41: JP3.9, L-RUN.K (C)
P42: JP3.10, R-TX.1
P43: JP3.11, R-RX.1
P44: JP3.12
P45: JP3.13
P46: JP3.14, SWD.1
P49: JP4.1, SWD.3
P50: JP4.2
P51: JP4.3
P52: JP4.4
P53: JP4.5
P54: JP4.6
P55: JP4.7
P56: JP4.8
P57: JP4.9
P58: JP4.10
P59: JP4.11
P61: JP4.13
P62: JP4.14
PUMP: OUTPUT.5, Q5.D
RX: OUT.2, R-TX.2
TPS: INPUT.4, R-TPS1.1
TX: OUT.1, R-RX.2
V12: C-V12.+, IC2.1 (VI), IC3.3 (IN), IC4.8 (VCC2), IC5.1 (VI), INPUT.7, R-FETB1.1, R-FETB2.1, R-FETB3.1, R-FETB4.1, R-FETC1.1, R-FETC2.1, R-FETC3.1, R-FETC4.1, R-PUMP2.2
VCC: C-VCC.+, IC2.3 (VO), IN.4, INPUT.5, X0.1
VCC_IAC: IC4.1 (1-2EN), IC4.9 (3-4EN), IC4.16 (VCC1), IC5.3 (VO), R-IACB1.1, R-IACB2.1, R-IACB3.1, R-IACB4.1
VDD: BOOT.1, C-VDD1.+, C-VDD2.2, D-V33.C, IC3.2 (OUT), JP1.1, JP1.13, JP2.3, JP2.16, JP3.16, JP4.16, OK-ICU.6 (VCC), OUT.4, R-FETA1.2, R-FETA2.2, R-FETA3.2, R-FETA4.2, R-IACA1.2, R-IACA2.2, R-IACA3.2, R-IACA4.2, R-ICU3.2, R-ICU4.2, R-ICU5.1, R-IPWR.2, R-NRST.1, R-PUMP1.2, R-RUN.2, R-VDD2.2, SWD.4
VSS: BOOT.3, C-ICU.2, C-NRST.1, C-TPS.2, C-VCC.-, C-VDD1.-, C-VDD2.1, C-X8A.1, C-X8A1.1, C-X8B.1, C-X8B1.1, D-V12.A, D-V33.A, IC2.2 (GND), IN.1, INPUT.1, INPUT.3, JP1.12, JP2.2, JP2.12, JP2.15, JP3.15, JP4.15, L-IPWR.K (C), OK-ICU.5 (GND), OUT.3, R-ICU2.1, R-TPS2.1, R-VDD1.1, S1.3, SWD.2, TR-ICU.E, X0.4, X0.S1, X0.S2

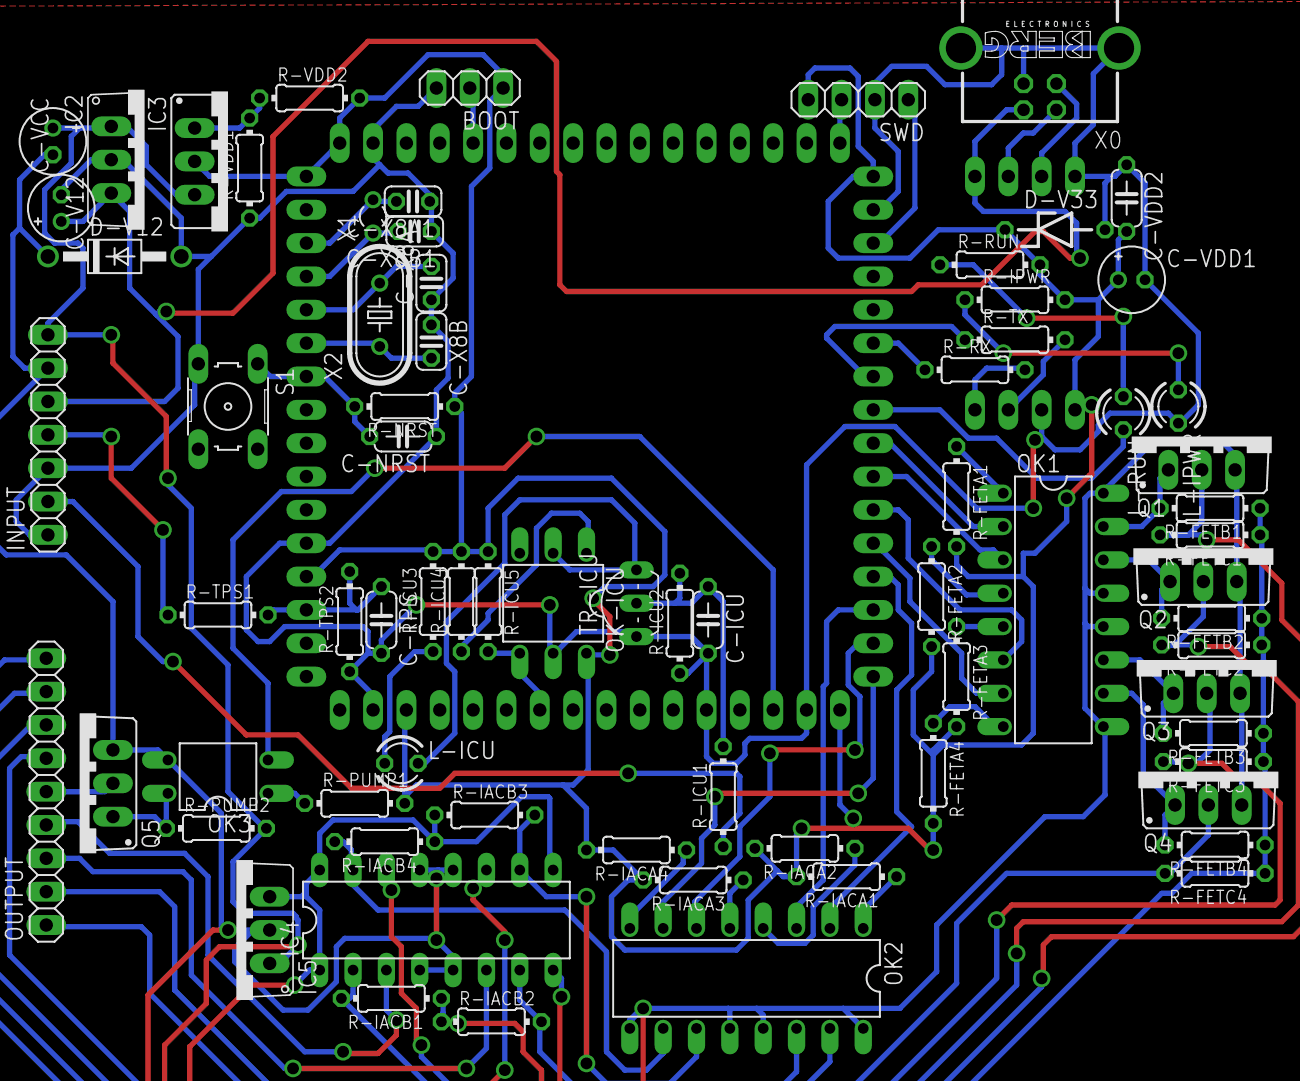
[picture p15: board platform2.brd from above]

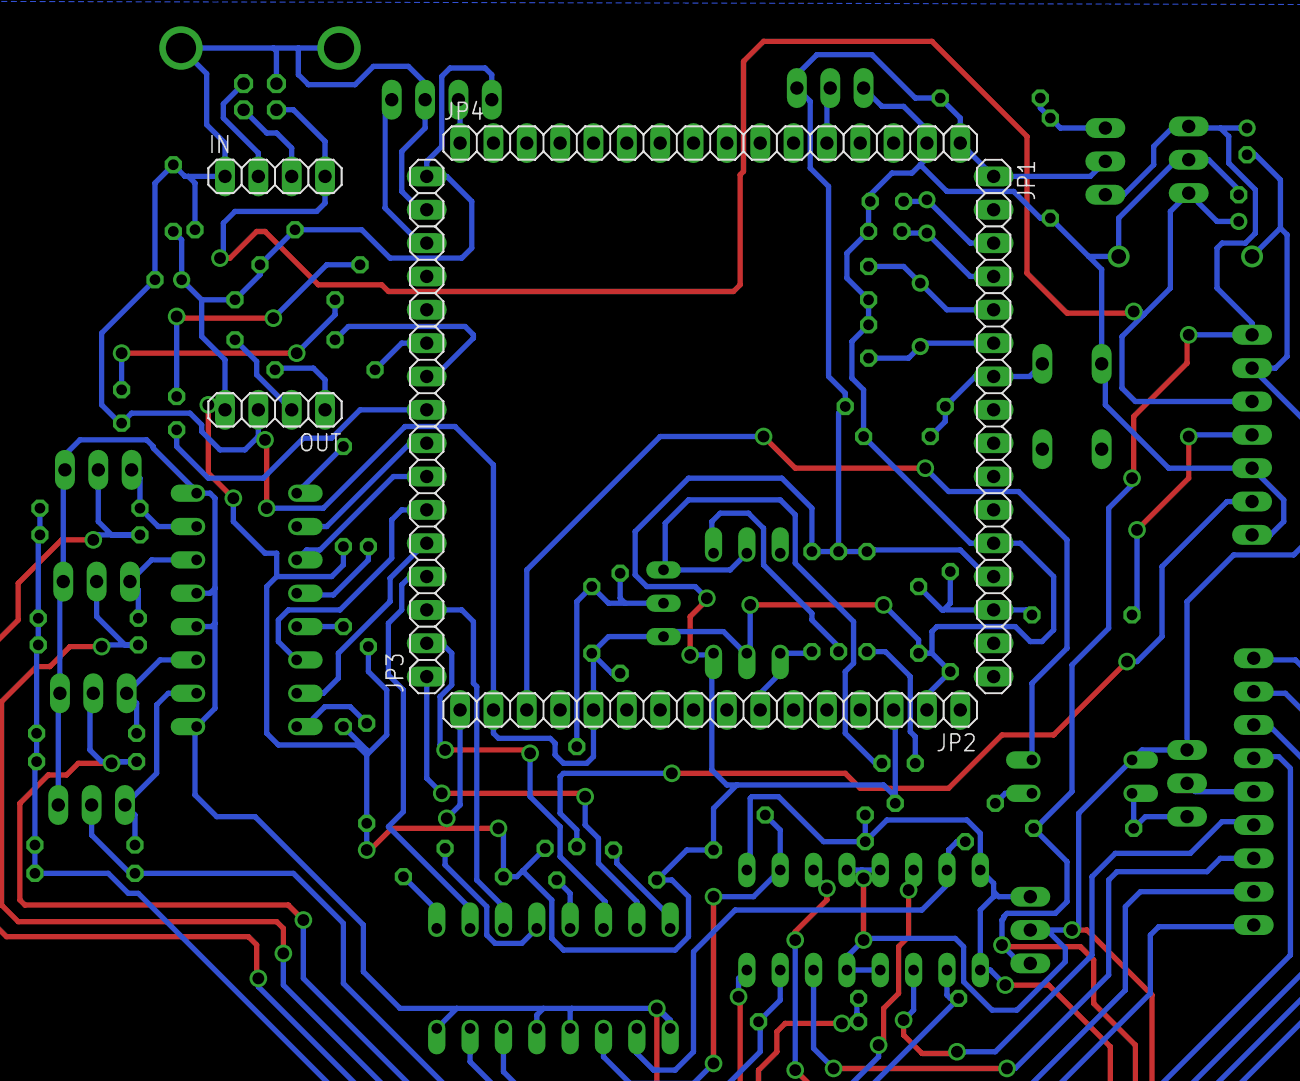
[picture p16: board platform2.brd from below]

Board: 2 copper layers, 80 parts (6 on the bottom side), 68 nets.
