mekatronik-achmadi/ecu_gea_v1/boards/PCB/ecu-new.brd

## EAGLE design boards/PCB/ecu-new.brd (2014-03-09)

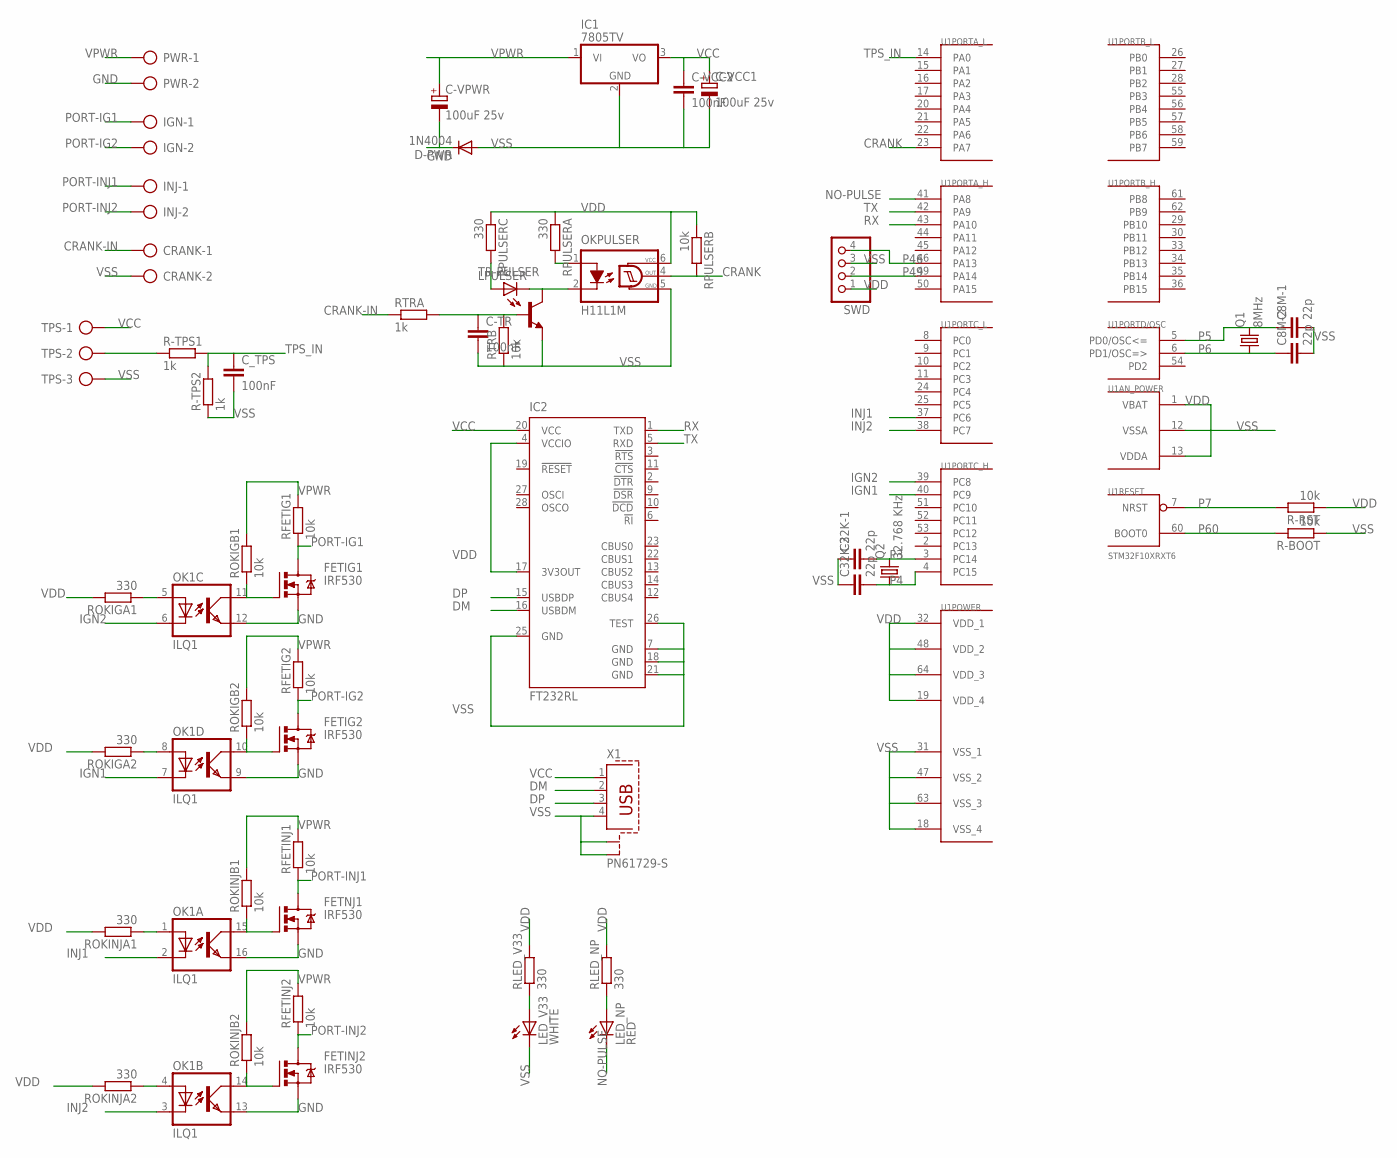
[picture p17: schematic ecu-new.sch]

Parts:
C8M-1, C8M-2, C32K-1, C32K-2: 22p; C025-030X050
C-TR: 100nF; C050-024X044
C-VCC1: 100uF 25v; E2,5-7
C-VCC2: 100nF; C050-024X044
C-VPWR: 100uF 25v; E2,5-7
CRANK: AK300/2
C_TPS: 100nF; C050-024X044
D-PWR: 1N4004; DO41-10
FETIG1, FETIG2: IRF530; TO220BV
FETINJ2: IRF530; TO220BV
FETNJ1: IRF530; TO220BV
IC1: 7805TV; TO220V
IC2: FT232RL; SSOP28
IGN: AK300/2
INJ: AK300/2
LED_NP: RED; LED3MM
LED_V33: WHITE; LED3MM
LPULSER: LED3MM
OK1: ILQ1; DIL16
OKPULSER: H11L1M; DIL06
PWR: AK300/2
Q1: 8MHz; HC49/S
Q2: 32.768 KHz; TC26H
R-BOOT: 10k; 0204/7
R-RST: 10k; 0204/7
R-TPS1, R-TPS2: 1k; 0204/7
RFETIG1, RFETIG2: 10k; 0204/7
RFETINJ1, RFETINJ2: 10k; 0204/7
RLED_NP: 330; 0204/7
RLED_V33: 330; 0204/7
ROKIGA1, ROKIGA2: 330; 0204/7
ROKIGB1, ROKIGB2: 10k; 0204/7
ROKINJA1, ROKINJA2: 330; 0204/7
ROKINJB1, ROKINJB2: 10k; 0204/7
RPULSERA: 330; 0204/7
RPULSERB: 10k; 0204/7
RPULSERC: 330; 0204/7
RTRA: 1k; 0204/7
RTRB: 10k; 0204/7
SWD: PINHD-1X4; 1X04
TPS: AK300/3
TR-PULSER: 2N3904-NPN-TO92-EBC; TO92-EBC
U1: STM32F10XRXT6; TQFP64
X1: PN61729-S

Connections:
CRANK: OKPULSER.4 (OUT), RPULSERB.2, U1.23 (PA7)
CRANK-IN: CRANK.1, RTRA.1
DM: IC2.16 (USBDM), X1.2
DP: IC2.15 (USBDP), X1.3
GND: C-VPWR.-, D-PWR.C, FETIG1.S, FETIG2.S, FETINJ2.S, FETNJ1.S, OK1.9 (EMIT), OK1.12 (EMIT), OK1.13 (EMIT), OK1.16 (EMIT), PWR.2
IGN1: OK1.7 (C), U1.40 (PC9)
IGN2: OK1.6 (C), U1.39 (PC8)
INJ1: OK1.2 (C), U1.37 (PC6)
INJ2: OK1.3 (C), U1.38 (PC7)
unnamed: OK1.4 (A), ROKINJA2.1
unnamed: C-TR.1, RTRA.2, RTRB.2, TR-PULSER.B
unnamed: OKPULSER.1 (A), RPULSERA.2
unnamed: LPULSER.A, RPULSERC.2
unnamed: LPULSER.K (C), OKPULSER.2 (C), TR-PULSER.C
unnamed: OK1.5 (A), ROKIGA1.1
unnamed: OK1.8 (A), ROKIGA2.1
unnamed: OK1.1 (A), ROKINJA1.1
unnamed: FETIG2.G, OK1.10 (COL), ROKIGB2.1
unnamed: FETNJ1.G, OK1.15 (COL), ROKINJB1.1
unnamed: FETIG1.G, OK1.11 (COL), ROKIGB1.1
unnamed: FETINJ2.G, OK1.14 (COL), ROKINJB2.1
unnamed: R-TPS1.1, TPS.2
unnamed: LED_V33.A, RLED_V33.1
unnamed: LED_NP.A, RLED_NP.1
NO-PULSE: LED_NP.K (C), U1.41 (PA8)
P3: C32K-1.2, Q2.2, U1.3 (PC14)
P4: C32K-2.2, Q2.1, U1.4 (PC15)
P5: C8M-1.1, Q1.2, U1.5 (PD0/OSC<=)
P6: C8M-2.1, Q1.1, U1.6 (PD1/OSC=>)
P7: R-RST.2, U1.7 (NRST)
P46: SWD.4, U1.46 (PA13)
P49: SWD.2, U1.49 (PA14)
P60: R-BOOT.2, U1.60 (BOOT0)
PORT-IG1: FETIG1.D, IGN.1, RFETIG1.1
PORT-IG2: FETIG2.D, IGN.2, RFETIG2.1
PORT-INJ1: FETNJ1.D, INJ.1, RFETINJ1.1
PORT-INJ2: FETINJ2.D, INJ.2, RFETINJ2.1
RX: IC2.1 (TXD), U1.43 (PA10)
TPS_IN: C_TPS.1, R-TPS1.2, R-TPS2.2, U1.14 (PA0)
TX: IC2.5 (RXD), U1.42 (PA9)
VCC: C-VCC1.+, C-VCC2.1, IC1.3 (VO), IC2.20 (VCC), TPS.1, X1.1
VDD: IC2.4 (VCCIO), IC2.17 (3V3OUT), OKPULSER.6 (VCC), R-RST.1, RLED_NP.2, RLED_V33.2, ROKIGA1.2, ROKIGA2.2, ROKINJA1.2, ROKINJA2.2, RPULSERA.1, RPULSERB.1, RPULSERC.1, SWD.1, U1.1 (VBAT), U1.13 (VDDA), U1.19 (VDD_4), U1.32 (VDD_1), U1.48 (VDD_2), U1.64 (VDD_3)
VPWR: C-VPWR.+, IC1.1 (VI), PWR.1, RFETIG1.2, RFETIG2.2, RFETINJ1.2, RFETINJ2.2, ROKIGB1.2, ROKIGB2.2, ROKINJB1.2, ROKINJB2.2
VSS: C8M-1.2, C8M-2.2, C32K-1.1, C32K-2.1, C-TR.2, C-VCC1.-, C-VCC2.2, CRANK.2, C_TPS.2, D-PWR.A, IC1.2 (GND), IC2.7 (GND), IC2.18 (GND), IC2.21 (GND), IC2.25 (GND), IC2.26 (TEST), LED_V33.K (C), OKPULSER.5 (GND), R-BOOT.1, R-TPS2.1, RTRB.1, SWD.3, TPS.3, TR-PULSER.E, U1.12 (VSSA), U1.18 (VSS_4), U1.31 (VSS_1), U1.47 (VSS_2), U1.63 (VSS_3), X1.4, X1.S1, X1.S2

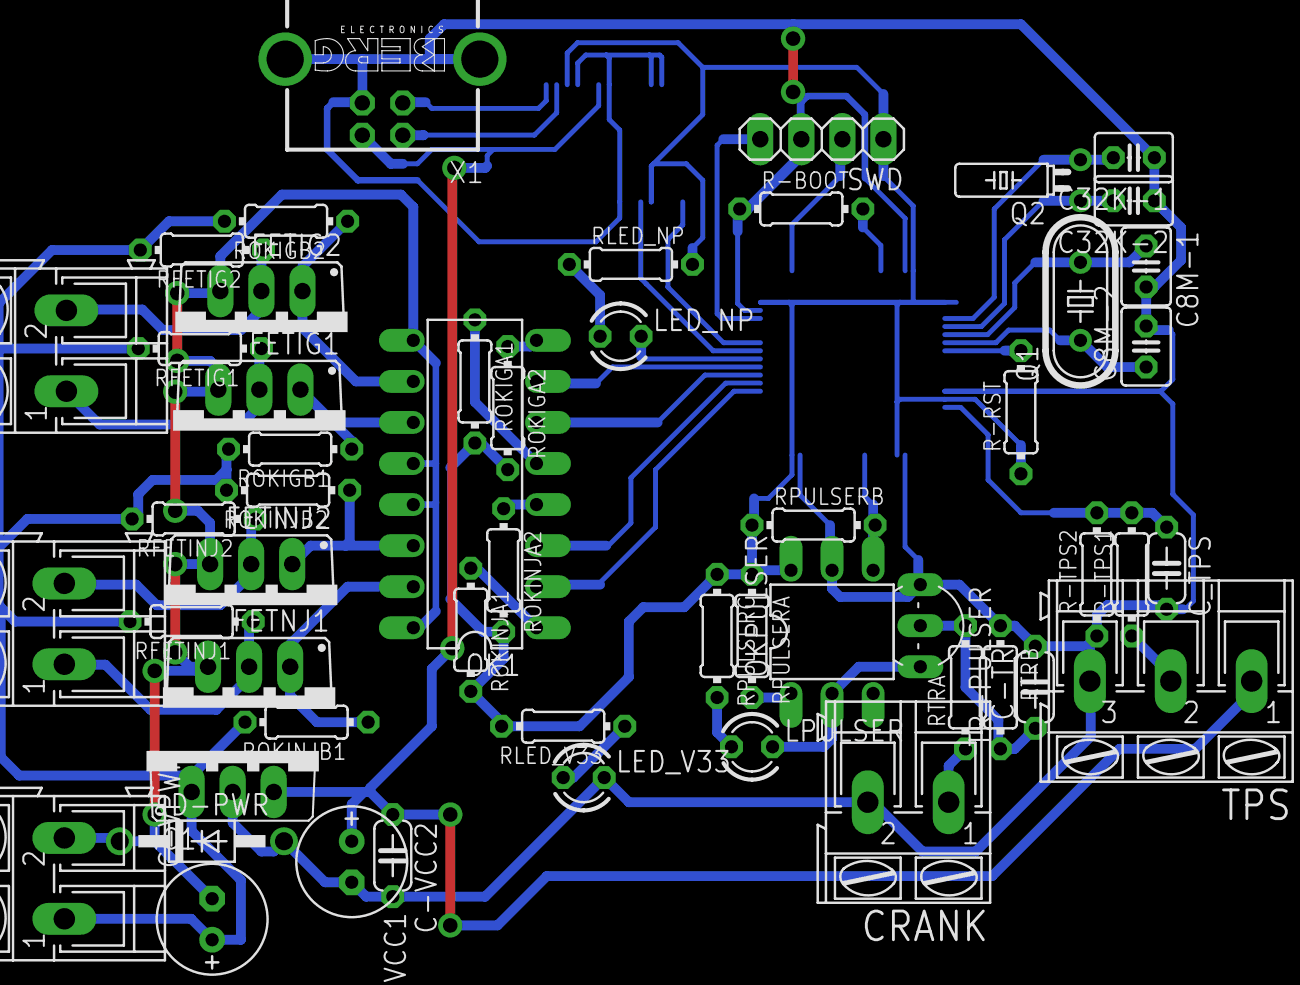
[picture p18: board ecu-new.brd from above]

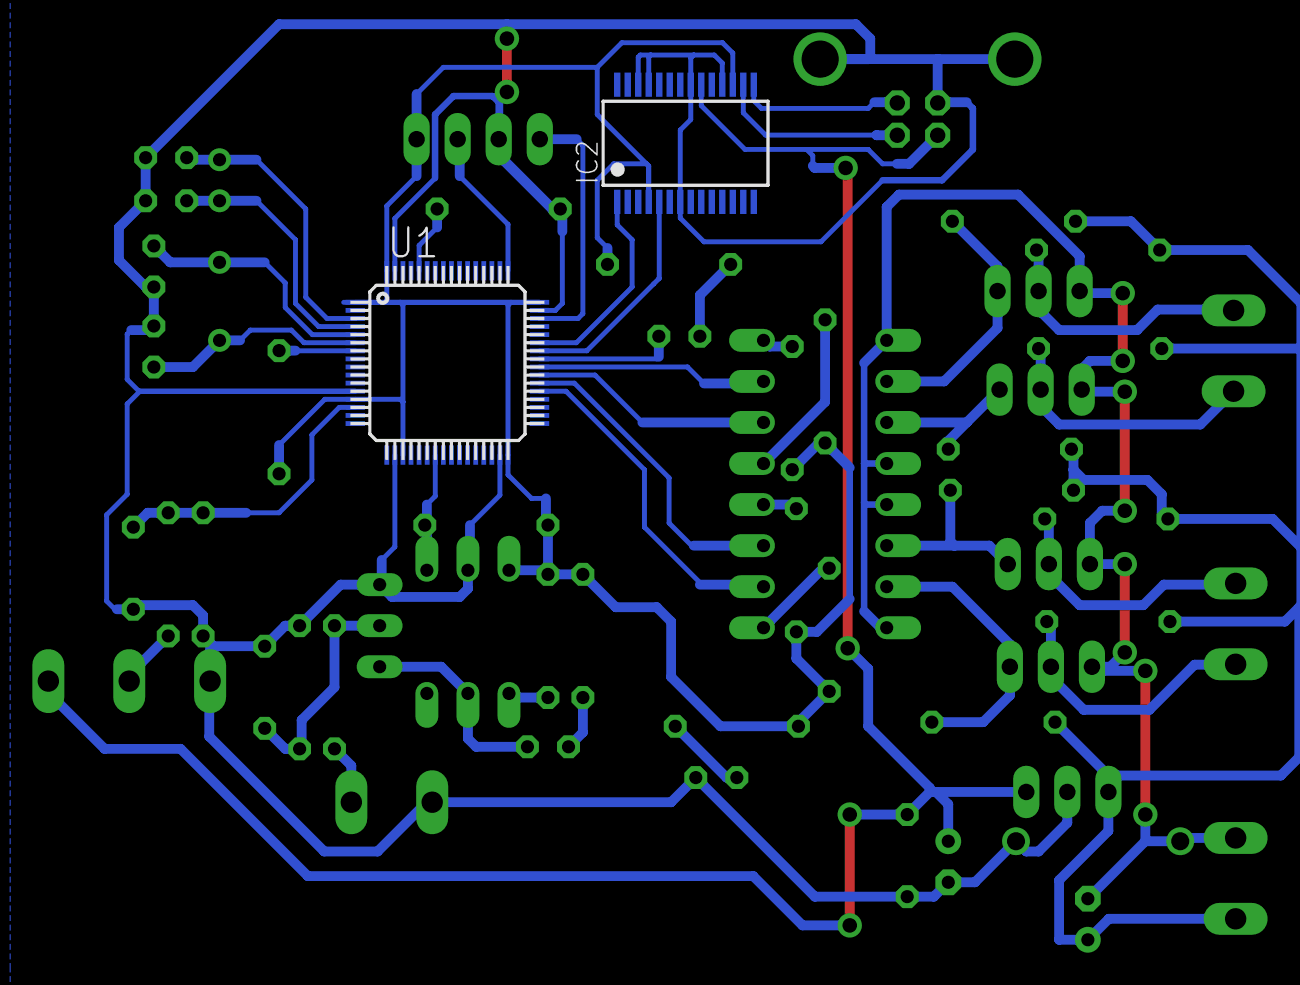
[picture p19: board ecu-new.brd from below]

Board: 2 copper layers, 55 parts (2 on the bottom side), 44 nets.
