mekatronik-achmadi/ecu_gea_v1/boards/PCB_Separated/iac_driver.brd

## EAGLE design boards/PCB_Separated/iac_driver.brd (2014-04-13)

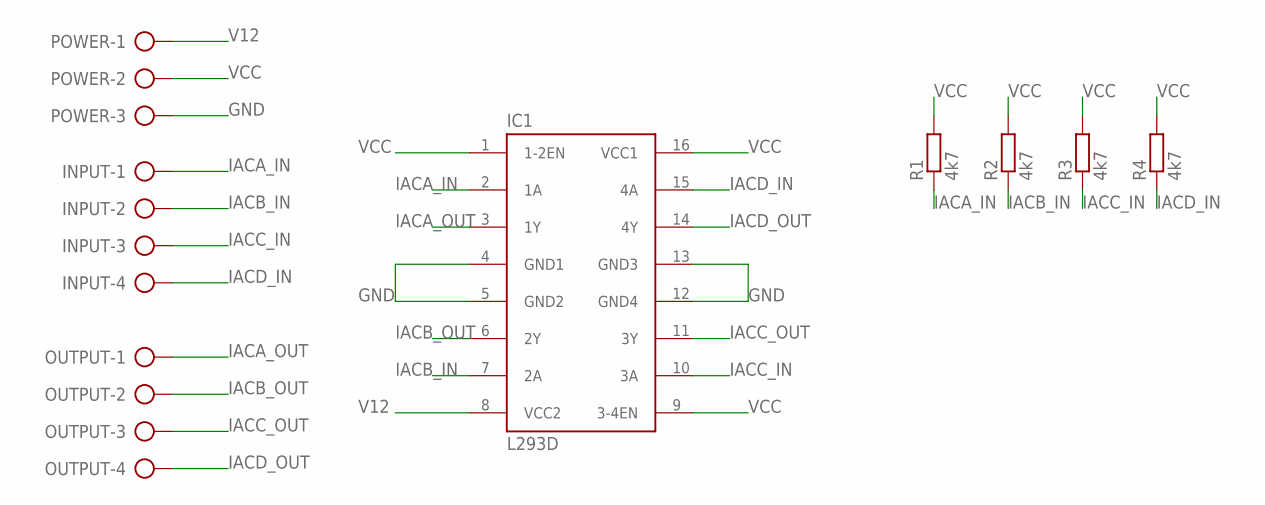
[picture p20: schematic iac_driver.sch]

Parts:
IC1: L293D; DIL16
INPUT: AK500/4
OUTPUT: AK500/4
POWER: AK500/3
R1, R2, R3, R4: 4k7; 0204/7

Connections:
GND: IC1.4 (GND1), IC1.5 (GND2), IC1.12 (GND4), IC1.13 (GND3), POWER.3
IACA_IN: IC1.2 (1A), INPUT.1, R1.1
IACA_OUT: IC1.3 (1Y), OUTPUT.1
IACB_IN: IC1.7 (2A), INPUT.2, R2.1
IACB_OUT: IC1.6 (2Y), OUTPUT.2
IACC_IN: IC1.10 (3A), INPUT.3, R3.1
IACC_OUT: IC1.11 (3Y), OUTPUT.3
IACD_IN: IC1.15 (4A), INPUT.4, R4.1
IACD_OUT: IC1.14 (4Y), OUTPUT.4
V12: IC1.8 (VCC2), POWER.1
VCC: IC1.1 (1-2EN), IC1.9 (3-4EN), IC1.16 (VCC1), POWER.2, R1.2, R2.2, R3.2, R4.2

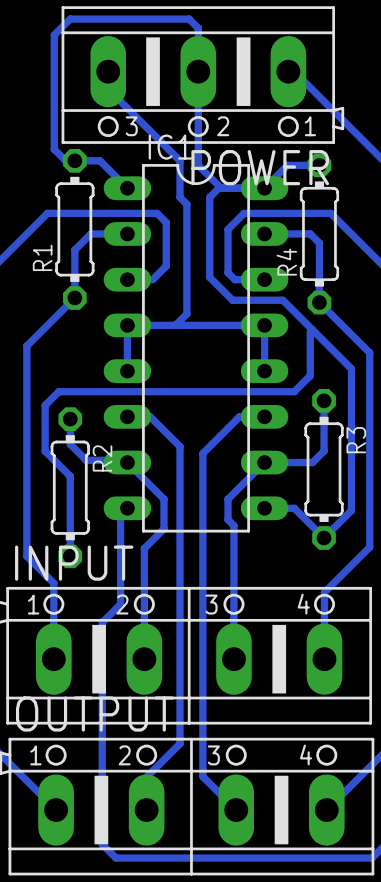
[picture p21: board iac_driver.brd from above]

Board: 2 copper layers, 8 parts (0 on the bottom side), 11 nets.
