mekatronik-achmadi/ecu_gea_v1/boards/PCB_Separated/connector.brd

## EAGLE design boards/PCB_Separated/connector.brd (2014-04-04)

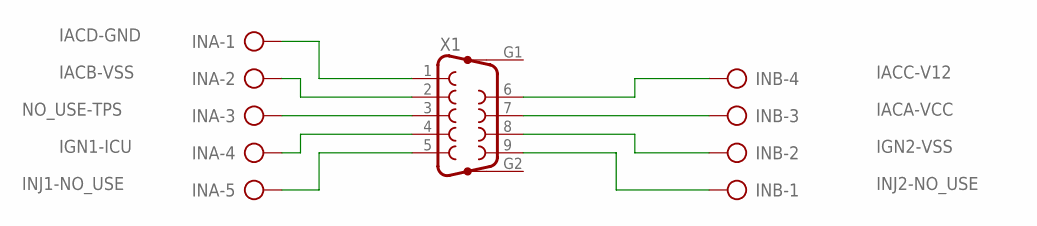
[picture p22: schematic connector.sch]

Parts:
INA: AK500/5
INB: AK500/4
X1: F09HP

Connections:
IACA-VCC: INB.3, X1.7
IACB-VSS: INA.2, X1.2
IACC-V12: INB.4, X1.6
IACD-GND: INA.1, X1.1
IGN1-ICU: INA.4, X1.4
IGN2-VSS: INB.2, X1.8
INJ1-NO_USE: INA.5, X1.5
INJ2-NO_USE: INB.1, X1.9
NO_USE-TPS: INA.3, X1.3

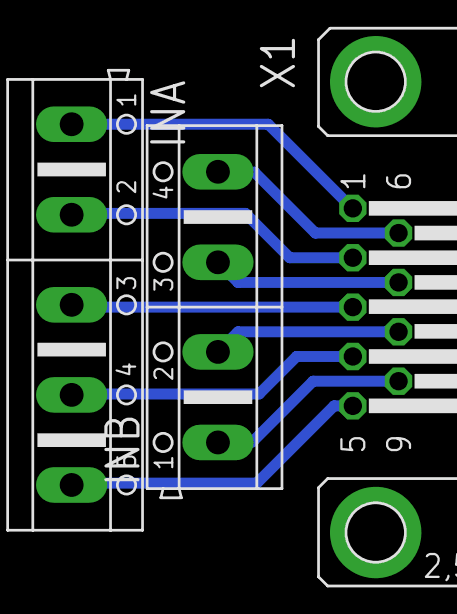
[picture p23: board connector.brd from above]

Board: 2 copper layers, 3 parts (0 on the bottom side), 9 nets.
