mekatronik-achmadi/ecu_gea_v1/boards/PCB_Separated/core.brd

## EAGLE design boards/PCB_Separated/core.brd (2014-03-26)

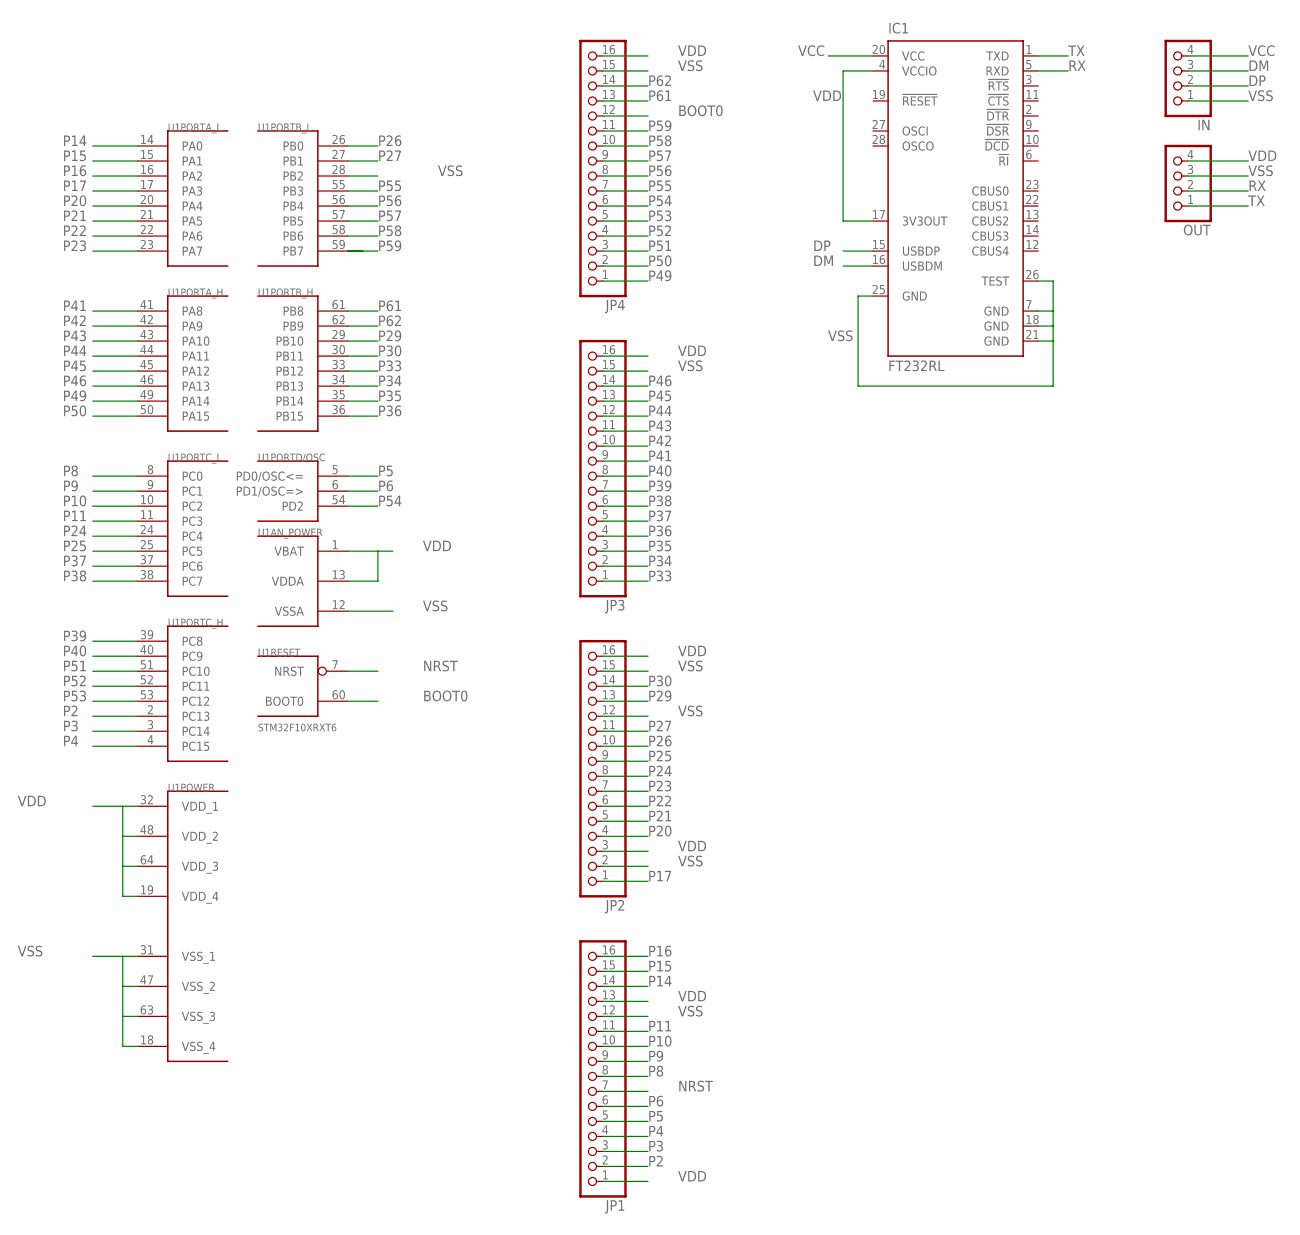
[picture p24: schematic core.sch]

Parts:
IC1: FT232RL; SSOP28
IN: PINHD-1X4; 1X04
JP1, JP2, JP3, JP4: PINHD-1X16; 1X16
OUT: PINHD-1X4; 1X04
U1: STM32F10XRXT6; TQFP64

Connections:
BOOT0: JP4.12, U1.60 (BOOT0)
DM: IC1.16 (USBDM), IN.3
DP: IC1.15 (USBDP), IN.2
NRST: JP1.7, U1.7 (NRST)
P2: JP1.2, U1.2 (PC13)
P3: JP1.3, U1.3 (PC14)
P4: JP1.4, U1.4 (PC15)
P5: JP1.5, U1.5 (PD0/OSC<=)
P6: JP1.6, U1.6 (PD1/OSC=>)
P8: JP1.8, U1.8 (PC0)
P9: JP1.9, U1.9 (PC1)
P10: JP1.10, U1.10 (PC2)
P11: JP1.11, U1.11 (PC3)
P14: JP1.14, U1.14 (PA0)
P15: JP1.15, U1.15 (PA1)
P16: JP1.16, U1.16 (PA2)
P17: JP2.1, U1.17 (PA3)
P20: JP2.4, U1.20 (PA4)
P21: JP2.5, U1.21 (PA5)
P22: JP2.6, U1.22 (PA6)
P23: JP2.7, U1.23 (PA7)
P24: JP2.8, U1.24 (PC4)
P25: JP2.9, U1.25 (PC5)
P26: JP2.10, U1.26 (PB0)
P27: JP2.11, U1.27 (PB1)
P29: JP2.13, U1.29 (PB10)
P30: JP2.14, U1.30 (PB11)
P33: JP3.1, U1.33 (PB12)
P34: JP3.2, U1.34 (PB13)
P35: JP3.3, U1.35 (PB14)
P36: JP3.4, U1.36 (PB15)
P37: JP3.5, U1.37 (PC6)
P38: JP3.6, U1.38 (PC7)
P39: JP3.7, U1.39 (PC8)
P40: JP3.8, U1.40 (PC9)
P41: JP3.9, U1.41 (PA8)
P42: JP3.10, U1.42 (PA9)
P43: JP3.11, U1.43 (PA10)
P44: JP3.12, U1.44 (PA11)
P45: JP3.13, U1.45 (PA12)
P46: JP3.14, U1.46 (PA13)
P49: JP4.1, U1.49 (PA14)
P50: JP4.2, U1.50 (PA15)
P51: JP4.3, U1.51 (PC10)
P52: JP4.4, U1.52 (PC11)
P53: JP4.5, U1.53 (PC12)
P54: JP4.6, U1.54 (PD2)
P55: JP4.7, U1.55 (PB3)
P56: JP4.8, U1.56 (PB4)
P57: JP4.9, U1.57 (PB5)
P58: JP4.10, U1.58 (PB6)
P59: JP4.11, U1.59 (PB7)
P61: JP4.13, U1.61 (PB8)
P62: JP4.14, U1.62 (PB9)
RX: IC1.5 (RXD), OUT.2
TX: IC1.1 (TXD), OUT.1
VCC: IC1.20 (VCC), IN.4
VDD: IC1.4 (VCCIO), IC1.17 (3V3OUT), JP1.1, JP1.13, JP2.3, JP2.16, JP3.16, JP4.16, OUT.4, U1.1 (VBAT), U1.13 (VDDA), U1.19 (VDD_4), U1.32 (VDD_1), U1.48 (VDD_2), U1.64 (VDD_3)
VSS: IC1.7 (GND), IC1.18 (GND), IC1.21 (GND), IC1.25 (GND), IC1.26 (TEST), IN.1, JP1.12, JP2.2, JP2.12, JP2.15, JP3.15, JP4.15, OUT.3, U1.12 (VSSA), U1.18 (VSS_4), U1.28 (PB2), U1.31 (VSS_1), U1.47 (VSS_2), U1.63 (VSS_3)
