mekatronik-achmadi/ecu_gea_v1/boards/PCB_Separated/core.brd

## EAGLE design boards/PCB_Separated/core.brd (continued)

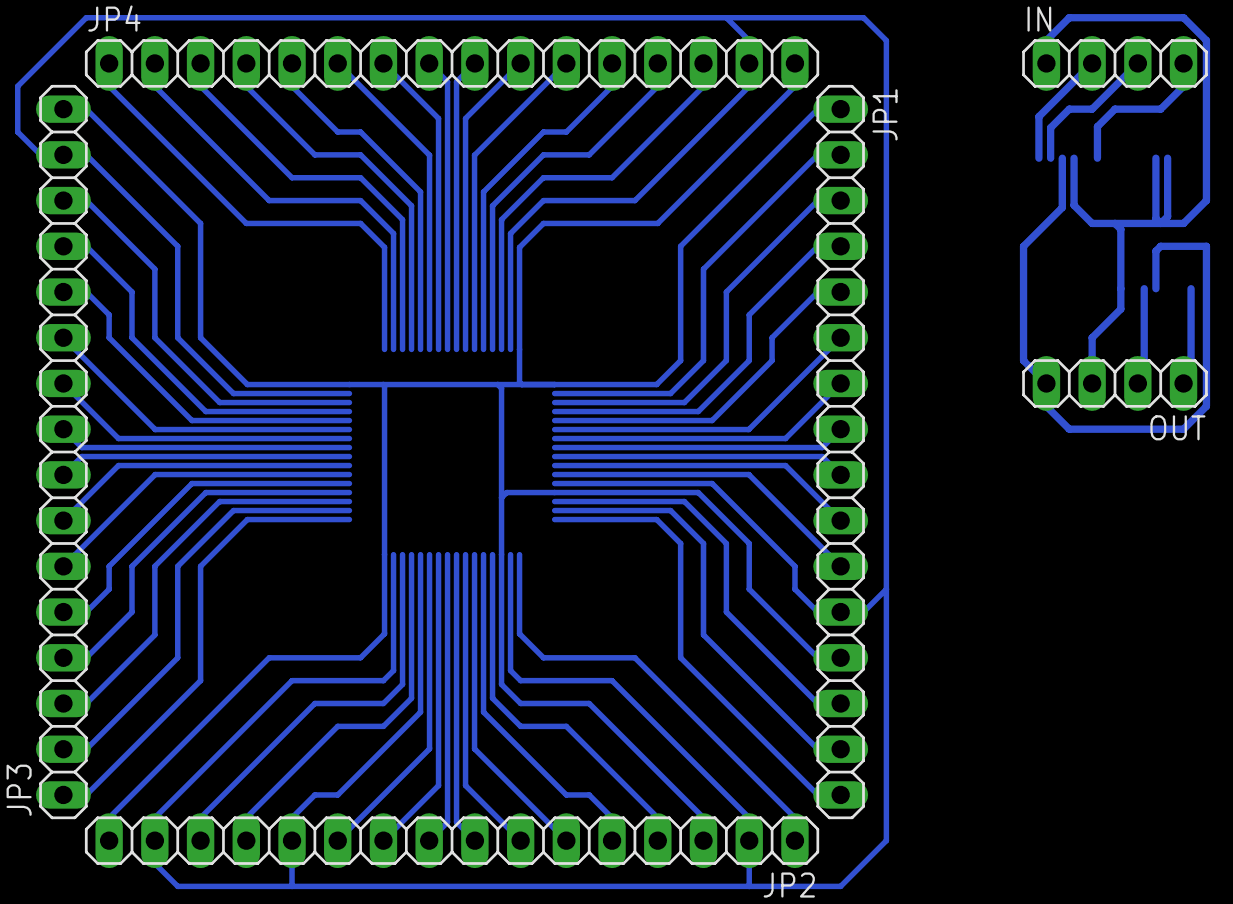
[picture p25: board core.brd from above]

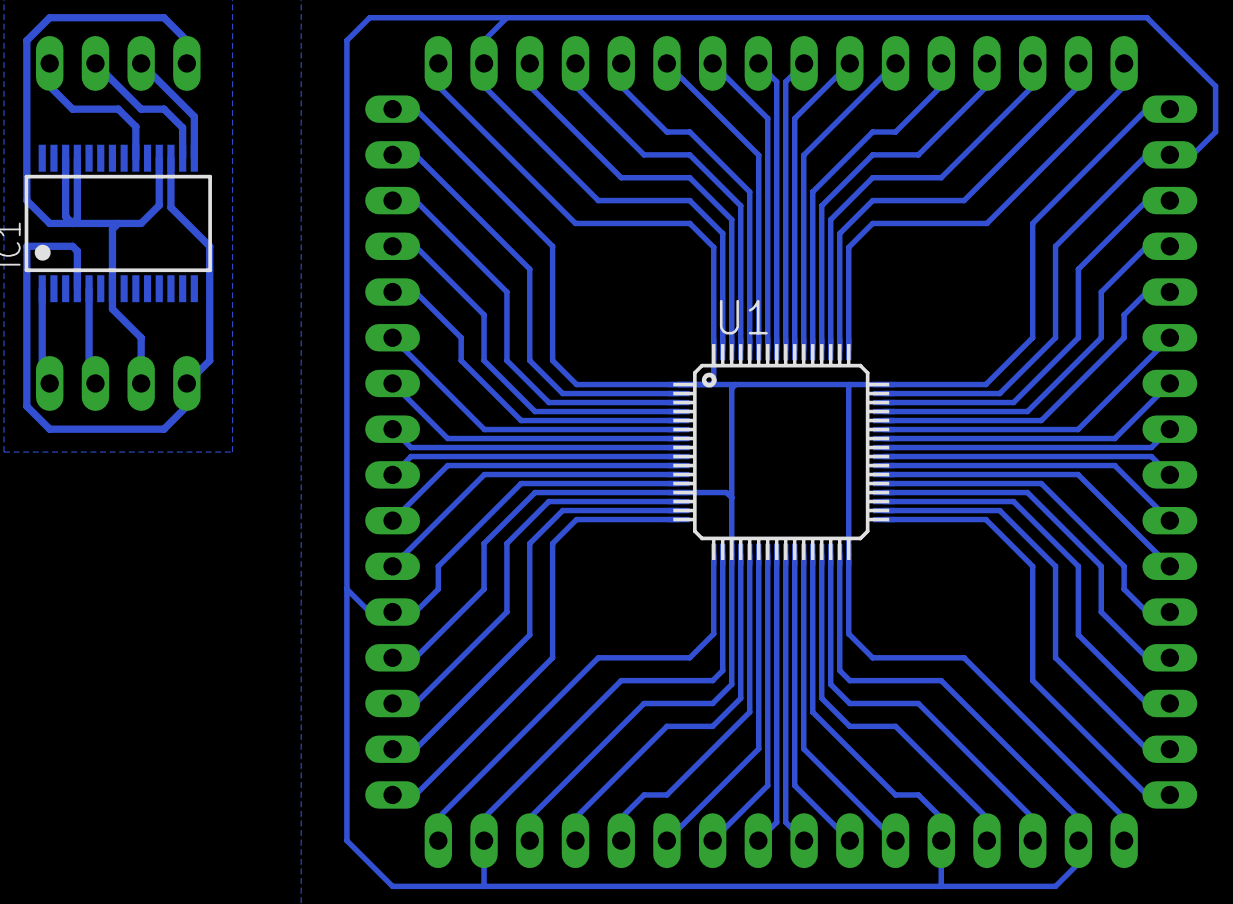
[picture p26: board core.brd from below]

Board: 2 copper layers, 8 parts (2 on the bottom side), 59 nets.
