mekatronik-achmadi/ecu_gea_v1/project/gea_sys.c

#include "srcconf.h"

extern adcsample_t adc_tps;
extern adcsample_t adc_clt;

extern icucnt_t last_period;
icucnt_t prev_last_period,rpm,frekuensi,misstooth;

uint8_t toothcount;

uint8_t id_rpm,id_tps;

uint16_t inj_data_ms_perc[cdata][cdata];
uint16_t ign_data_off_deg[cdata][cdata];
adcsample_t adc_tps_close,adc_tps_full;
uint16_t inj_ms_base,inj_open_time;

//uint16_t inj_data_ms_perc[cdata][cdata]={
  
  ////    500,	750,	1000,	1250,	1500,	2000,	2500,	3000,	4000,	5000,	5500,	6000
  //{	44,	26,	13,	 4,	 0,	 0,	 0,	 0,	 0,	 0,	 0,	 0}, // 0
  //{	26,	29,	33,	35,	37,	40,	42,	44,	51,	55,	57,	59}, // 10
  //{	28,	30,	34,	37,	39,	41,	43,	45,	52,	56,	59,	61}, // 15
  //{	29,	32,	36,	38,	40,	43,	45,	47,	54,	58,	60,	62}, // 20
  //{	36,	38,	43,	45,	48,	50,	52,	54,	61,	65,	68,	70}, // 30
  //{	38,	40,	44,	46,	48,	51,	54,	56,	63,	67,	70,	74}, // 40
  //{	40,	42,	47,	48,	50,	52,	57,	57,	62,	70,	72,	74}, // 50
  //{	42,	45,	50,	52,	55,	57,	62,	62,	69,	75,	77,	80}, // 60
  //{	44,	47,	51,	53,	56,	59,	62,	62,	74,	79,	82,	84}, // 70
  //{	45,	48,	52,	55,	57,	59,	64,	64,	74,	81,	82,	84}, // 80
  //{	47,	49,	54,	97,	97,	97,	97,	97,	88,	88,	88,	88}, // 90
  //{	48,	50,	57,	97,	97,	97,	97,	97,	88,	88,	88,	88}  // 100
//};

//uint16_t ign_data_off_deg[cdata][cdata]={
  
  ////    500,	750,	1000,	1250,	1500,	2000,	2500,	3000,	4000,	5000,	5500,	6000
  //{	10,	15,	15,	18,	20,	22,	25,	25,	27,	27,	30,	30}, // 0
  //{	10,	15,	15,	18,	20,	22,	25,	25,	27,	27,	30,	30}, // 10
  //{	10,	15,	15,	18,	20,	22,	25,	25,	27,	27,	30,	30}, // 15
  //{	10,	15,	15,	18,	20,	22,	25,	25,	27,	27,	30,	30}, // 20
  //{	10,	15,	15,	18,	20,	22,	25,	25,	27,	27,	30,	30}, // 30
  //{	10,	15,	15,	18,	20,	22,	25,	25,	27,	27,	30,	30}, // 40
  //{	10,	15,	15,	18,	20,	22,	25,	25,	27,	27,	30,	30}, // 50
  //{	10,	15,	15,	18,	20,	22,	25,	25,	27,	27,	30,	30}, // 60
  //{	10,	15,	15,	18,	20,	22,	25,	25,	27,	27,	30,	30}, // 70
  //{	10,	15,	15,	18,	20,	22,	25,	25,	27,	27,	30,	30}, // 80
  //{	10,	15,	15,	18,	20,	22,	25,	25,	27,	27,	30,	30}, // 90
  //{	10,	15,	15,	18,	20,	22,	25,	25,	27,	27,	30,	30}  // 100
//};

//adcsample_t adc_tps_close=195,adc_tps_full=1395;
//uint16_t inj_ms_base=5,inj_open_time=200;

uint16_t data_tps[cdata]={0,10,15,20,30,40,50,60,70,80,90,100};
uint16_t data_rpm[cdata]={500,750,1000,1250,1500,2000,2500,3000,4000,5000,5500,6000};

uint16_t inj_ms_perc,inj_ms_tick;
uint16_t ign_off_deg,ign_off_deg_out,ign_off_tick,one_deg_tick;

uint8_t rpm_index,tps_index;

void engine_calc(void){
  
  if(last_period > 0){
    misstooth = (prev_last_period*100) / last_period;
    prev_last_period =  last_period; 
  } 
  
  if((misstooth>40)&&(misstooth<60)){  
    toothcount=0;
  }
  else{
    frekuensi = F_ICU / last_period;
    rpm = frekuensi*60/(all_tooth+1);
    
    one_deg_tick=last_period/deg_per_tooth;
    
    toothcount++;
  }
  
  if(toothcount==all_tooth+1){toothcount=0;}
  if(toothcount==all_tooth+2){toothcount=1;} 
}

void inj_ign(void){
  
    int i;
    
    
    for(i=0;i<cdata-2;i++){
        if((rpm>=data_rpm[i])&&(rpm<data_rpm[i+1])){
	  rpm_index=i;
        }
    };
    
    if(rpm<data_rpm[0]){
        rpm_index=0;
    }

    if(rpm>=data_rpm[cdata-1]){
        rpm_index=cdata-1;
    }
    
	  
    for(i=0;i<cdata-2;i++){
        if((adc_tps>=data_tps[i])&&(adc_tps<data_tps[i+1])){
            tps_index=i;
        }
    };

    if(adc_tps<data_tps[0]){
        tps_index=0;
    }

    if(adc_tps>=data_tps[cdata-1]){
        tps_index=cdata-1;
    }
    
    id_tps=tps_index;
    id_rpm=rpm_index;
  
    inj_ms_perc=inj_data_ms_perc[tps_index][rpm_index];
    ign_off_deg=ign_data_off_deg[tps_index][rpm_index];

    if(adc_clt<temp_limit){inj_ms_base=inj_ms_base-inj_temp;}
    
    inj_ms_tick=(inj_ms_perc*inj_ms_base)+inj_open_time;
    
    ign_off_deg_out=31-ign_off_deg;
    ign_off_tick=ign_off_deg_out*one_deg_tick;
}

void engine_set(void){
  
  if(toothcount==intake_port_open){
    
    on_inj1;
    on_inj2;
    
    chSysLockFromIsr();
    gptStartOneShotI(&GPTD2, inj_ms_tick);
    chSysUnlockFromIsr();
  }
  
  if(toothcount==intake_port_close){
    off_inj1;
    off_inj2;
  }
  
  if(toothcount==coil_on){
    on_ign1;
    on_ign2;
  }
  
  if(toothcount==coil_off){
    chSysLockFromIsr();
    gptStartOneShotI(&GPTD4, ign_off_tick);
    chSysUnlockFromIsr();
  }
}

void inj_out(void){
  off_inj1;
  off_inj2;
}

void ign_out(void){
  off_ign1;
  off_ign2;
}

void engine_ovf(void){
  
  no_pulse;
  frekuensi = 0;
  rpm=0;
  misstooth=0;

  off_inj1;
  off_inj2;
  off_ign1;
  off_ign2;
  
}

void data_send(void){

   chprintf((BaseSequentialStream *)&SD1,
    "%i,%i,%i,%i,%i,%i,%i,%i,%i,%i,%i,%i\r\n",
   rpm,adc_tps,inj_ms_perc,inj_ms_tick,ign_off_deg,ign_off_tick,one_deg_tick,id_rpm,id_tps,inj_open_time,inj_ms_base,adc_clt
  );
}
