mekatronik-achmadi/ecu_gea_v1/project/srcconf.h

#ifndef SRC_CONF
#define SRC_CONF

#include <stdio.h>
#include <string.h>
#include <stdint.h>
#include <stdarg.h>
#include <stdlib.h>
#include <math.h>

#include "ch.h"
#include "hal.h"

#include "memstreams.h"
#include "shell.h"
#include "chprintf.h"
#include "evtimer.h"

#include "gea_shell.h"
#include "gea_icu.h"
#include "gea_adc.h"
#include "gea_sys.h"
#include "gea_pal.h"
#include "gea_gpt.h"
#include "gea_mem.h"

#include "stm32f10x_flash.h"
#include "stm32f10x_eeprom.h"

#define assert_param(expr) ((void)0)

#endif
