mekatronik-achmadi/ecu_gea_v1/(commit log)

2014-03-09 add a new separatedly-style board
    [core_ft232.brd, core_ft232.sch, core_stm32.brd, core_stm32.sch]
2014-03-10 Modify Board. Core and FTDI become one file
    [core.brd, core.sch, core_ft232.brd, core_ft232.sch]
2014-03-11 add platform board
    [platform.brd, platform.sch]
2014-03-16 perbaikan konversi sudut ke tick timer
2014-03-22 copy from james's PC
    [core.brd, core.sch, ecu-new.brd, ecu-new.sch, platform.brd, platform.sch]
2014-03-26 -delete a useless sch pics -add ecu io pins diagram -add a GND to VSS line on FTDI. Hopefully internally connected with other GND pins -progress new separated ecu board.
    [core.brd, core.sch, platform.brd, platform.sch]
2014-03-26 progress to build new ecu boards
    [platform.brd, platform.sch]
2014-04-04 add connector board
    [connector.brd, connector.sch, platform.brd, platform.sch]
2014-04-04 add label on connector design
    [connector.brd, connector.sch]
2014-04-09 progress buat IAC
    [fet_iac.brd, fet_iac.sch]
2014-04-10 progress for IAC
    move resistor on mainborad to IAC driver to get 5v logic instead of 12v logic
    [iac_driver.brd, iac_driver.sch]
2014-04-13 IAC progress. Valve already driven, but there a problem with voltage while USB connected to PC
    [fet_iac.brd, fet_iac.sch, iac_driver.brd, iac_driver.sch]
2014-04-13 add more cycle for opening iac (CCW rotation)
    L293D circuit should use separate VCC regulator
2014-04-16 new commit and IAC progress
    [ecu-new.brd, ecu-new.sch]
2014-05-11 problem with tick for 1 degree
    [gea_adc.c, gea_icu.c, gea_shell.c, gea_sys.c, gea_sys.h, main.c]
2014-05-12 Idle seems good
    next:
    1. try accel and de-accel
2014-05-17 board integrated & double-layered
    [platform2.brd, platform2.sch]
2014-05-19 gak jadi bikin pcb baru dulu
    [platform2.brd, platform2.sch]
2014-05-21 add new board but same schematic
    - fix startup firing bug
    - add enrichment sensor
    - interface for setting
    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
    [platform2.brd, platform2.sch]
2014-05-29 working on interface
    [platform_smd.brd, platform_smd.sch]
2014-06-16 run test again
    [platform_smd.brd, platform_smd.sch]
2014-06-22 tinggal save
    [platform_smd2.brd, platform_smd2.sch, platform_smd2_driver.brd, platform_smd2_driver.sch]
2014-06-23 nambah input analog untuk map, mat,clt
    [platform_smd2_map.brd, platform_smd2_map.sch]
2014-06-25 Add Bill Of Material untuk platform_smd2_map dan platform_smd2_driver
    note: desain platform_smd2_map pada L-ICU masih dengan led 0805 dan harus diganti dengan led 1206
    [bom_platform_smd2_map_driver.xls]
2014-06-26 perbaikan desain board
    [platform_smd2_map2.brd, platform_smd2_map2.sch]
2014-06-27 fix some bugs
    [platform_smd2_driver.brd, platform_smd2_driver.sch]
2014-07-03 coolant measurement
    [platform_smd2_map2.brd, platform_smd2_map2.sch]
2014-07-05 pump setting
2014-07-10 new baord with o2 analog input
    [platform_smd2_o2.brd, platform_smd2_o2.sch]
2014-07-17 all featured board versi 1
    [platform_all1.brd, platform_all1.sch, platform_driver_all1.brd, platform_driver_all1.sch]
2014-09-03 revisi driver
    [platform_all1.brd, platform_driver_all2.brd, platform_driver_all2.sch]
2014-09-16 revisi board driver v2
    [platform_driver_all2.brd]
2014-09-28 edit mini usb and deactivate delayed startup
    [platform_all1.brd, platform_all1.sch]
